SSkrzypik03/DigitalAmplifier/img/front_view_3.jpg

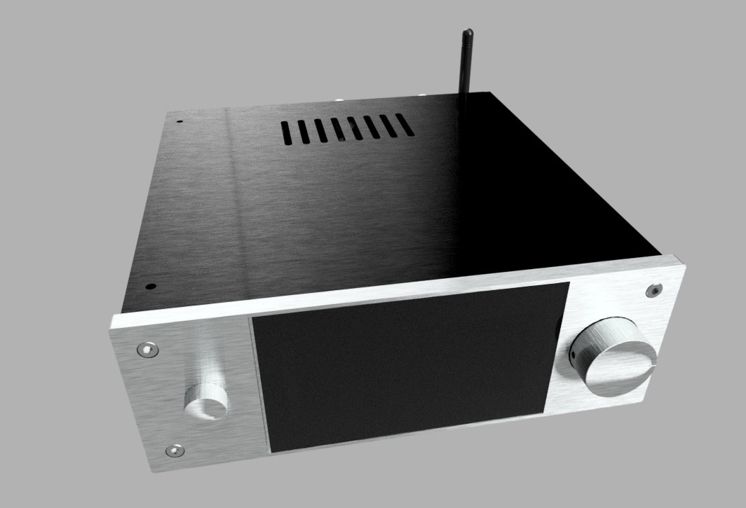
img/front_view_3.jpg
