SSkrzypik03/DigitalAmplifier/img/rear_view_1.jpg

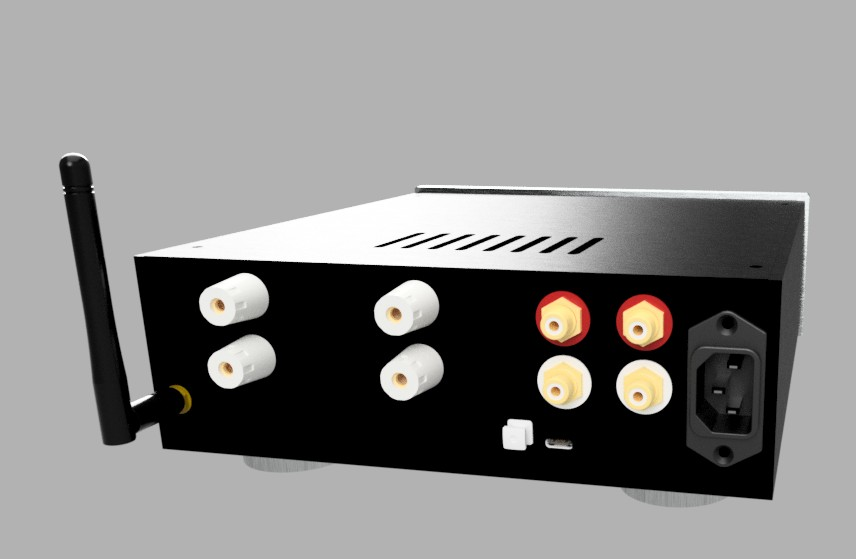
img/rear_view_1.jpg
