SSkrzypik03/DigitalAmplifier/cad/electronics_parts/power_supply_unit.step

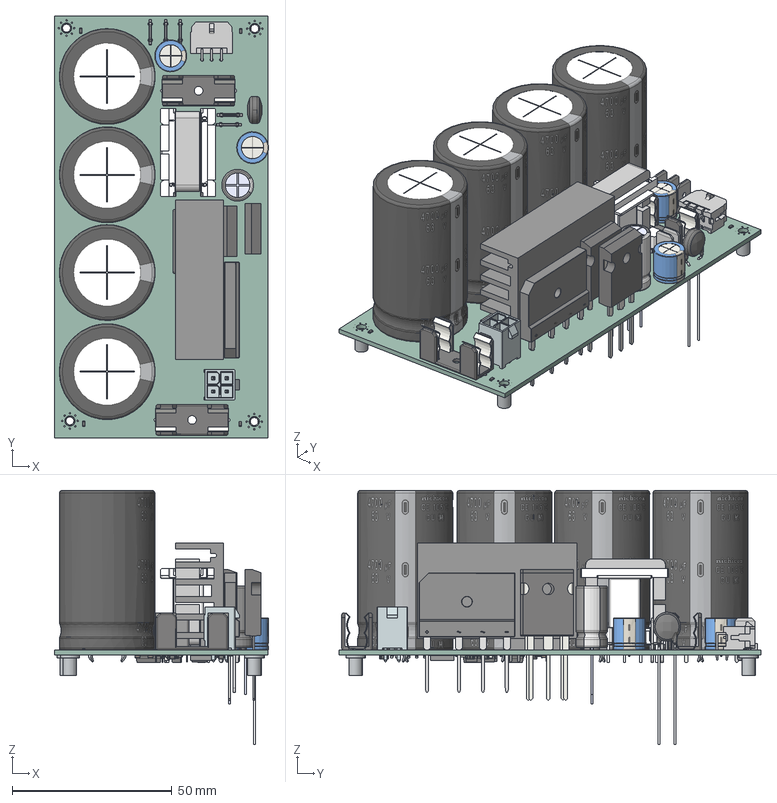
[picture p11: CAD file, 2026-06-03]
cad/electronics_parts/power_supply_unit.step
67.1 x 132.3 x 79.7 mm
9775056360R x 4
4700uF 63V Electr 30 x50 -P.diameter 10mm x 4
R_0603_1608Metric x 18
TO-247-3_Vertical
B66208W1010T001
B66317G0000X187 x 2
CP_Radial_D10.0mm_P2.50mm x 2
D15XB80-7000
RAD-DY-GF_5
Fuseholder_Cylinder-5x20mm_Schurter_0031_8201_Horizontal_Open x 2
B57153S0330M000
EEUFM1H271E
TO-247-2_Vertical
Pins
D_SMB x 2
SOT-23 x 2
SOT457 Lower body
SOT457 Lead x 6
SOT457 Upper body
PS2811-1-F3-A
C_0603_1608Metric x 9
D_SMA x 2
D_SOD-123
BODY-SOT_1 x 2
LEAD-SOT_1 x 10
LEAD-DUMMY x 2
D_SMC
BODY-SOT
LEAD-SOT x 6
R_2512_6332Metric
C_1206_3216Metric
R_2010_5025Metric
supply_PCB
