SSkrzypik03/DigitalAmplifier/cad/housing_parts/transformer_enclosure.step

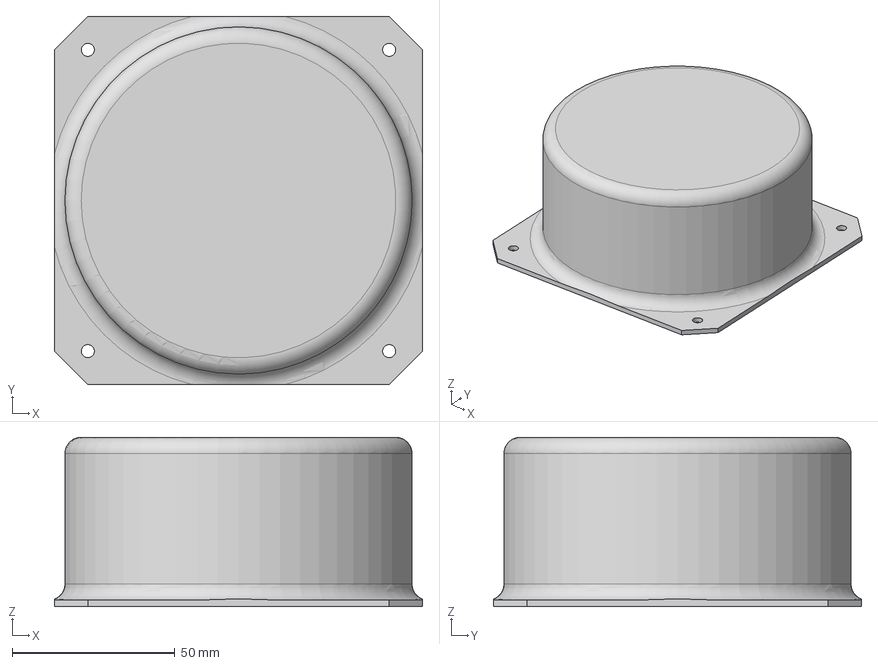
[picture p12: CAD file, 2026-06-03]
cad/housing_parts/transformer_enclosure.step
113.0 x 113.0 x 52.0 mm
