SSkrzypik03/DigitalAmplifier/hardware/front_panel/front_26_05_26.step

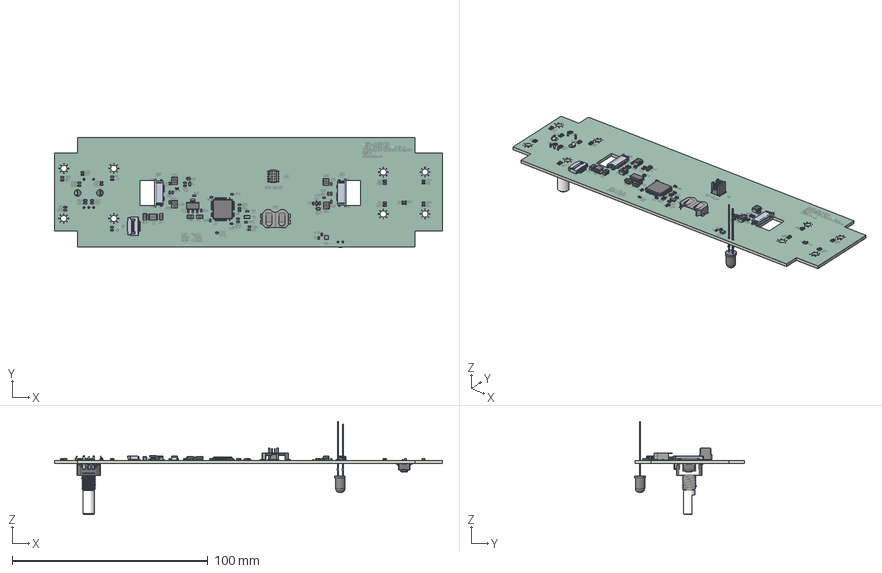
[picture p13: CAD file, 2026-06-01]
hardware/front_panel/front_26_05_26.step
198.4 x 56.4 x 47.8 mm
SOT-223
C_0603_1608Metric x 39
QT3CD-32.768KDZY-T
293D475X9016B2TE3 x 4
D_SOD-323F x 4
R_0603_1608Metric x 20
FTSH-105-01-L-DV-K
293D226X9010A2TE3 x 4
LQFP-64_10x10mm_P0.5mm
D_SOD-523
Kern x 2
Pin x 2
front_26_05_26 1.42.1
ThermalPin
PinsArrayLR
BatteryHolder_LINX_BAT-HLD-012-SMT
SW_SPST_PTS645Sx43SMTR92
SFH_203_FA
PEC11R-4220F-S0024
FrontPanel_silkscreen x 2
FrontPanel_soldermask x 2
FrontPanel_PCB
