SSkrzypik03/DigitalAmplifier/hardware/supply/supply_30_05_26.step

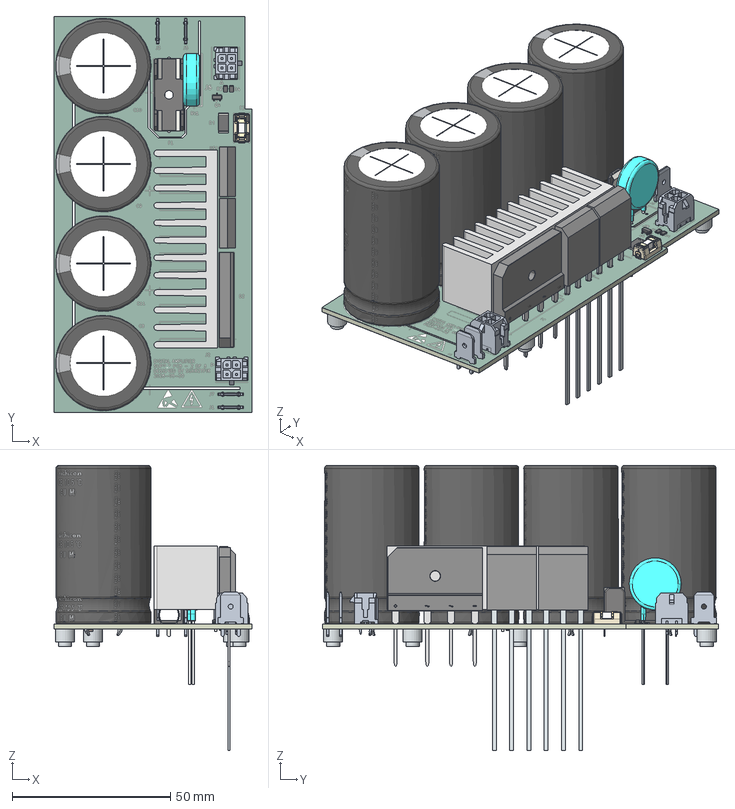
[picture p14: CAD file, 2026-06-01]
hardware/supply/supply_30_05_26.step
62.4 x 125.0 x 90.0 mm
4700uF 63V Electr 30 x50 -P.diameter 10mm x 4
Fuseholder_Cylinder-5x20mm_Schurter_0031_8201_Horizontal_Open
R_0805_2012Metric x 2
SOT-23
R_2512_6332Metric
PinsArray x 2
sk444
D15XB80-7000
MOV-14D431K
0679H1000-xxsingle fonts v2.step
Plastic holder-0.step
Terminal.step
9774040360R (rev1) x 5
R_0603_1608Metric x 3
C_0603_1608Metric x 3
supply_silkscreen x 2
supply_soldermask x 2
supply_PCB
