SSkrzypik03/DigitalAmplifier/cad/electronics_parts/front_panel.step

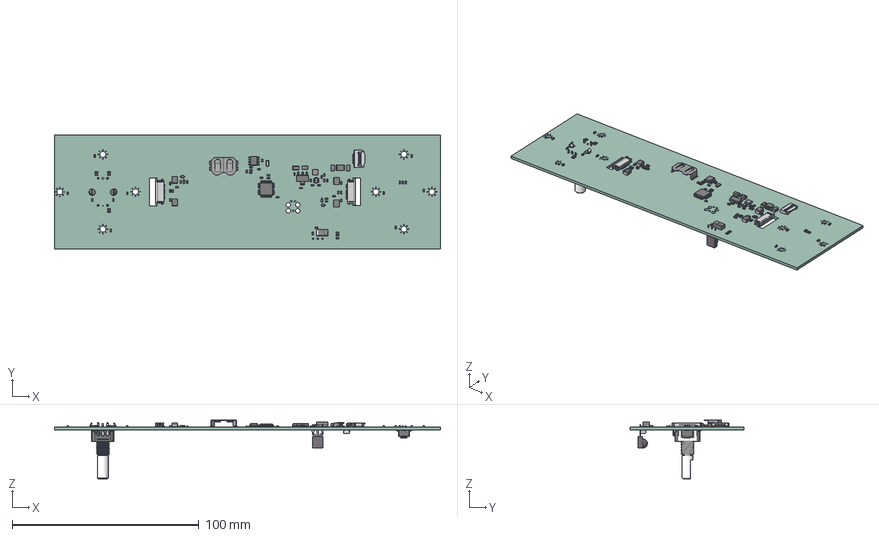
[picture p15: CAD file, 2026-06-03]
cad/electronics_parts/front_panel.step
206.8 x 61.1 x 31.5 mm
SOT-223
C_0603_1608Metric x 38
R_0603_1608Metric x 18
QT3CD-32.768KDZY-T
293D475X9016B2TE3 x 4
D_SOD-323F x 4
SOIC-8_3.9x4.9mm_P1.27mm
293D226X9010A2TE3 x 4
BODY-SOT
LEAD-SOT x 6
D_SOD-523
Kern
Kern_1
Pin
Pin_1
FrontPanel 1.38.1
LQFP-48_7x7mm_P0.5mm
293D476X96R3C2TE3
Pins
BatteryHolder_LINX_BAT-HLD-012-SMT
ASMB-MTB1-0B3A2
SW_SPST_PTS645Sx43SMTR92
Vishay_MINIMOLD-3Pin
PEC11R-4220F-S0024
FrontPanel_PCB
