SSkrzypik03/DigitalAmplifier/cad/housing_parts/volume_knob.step

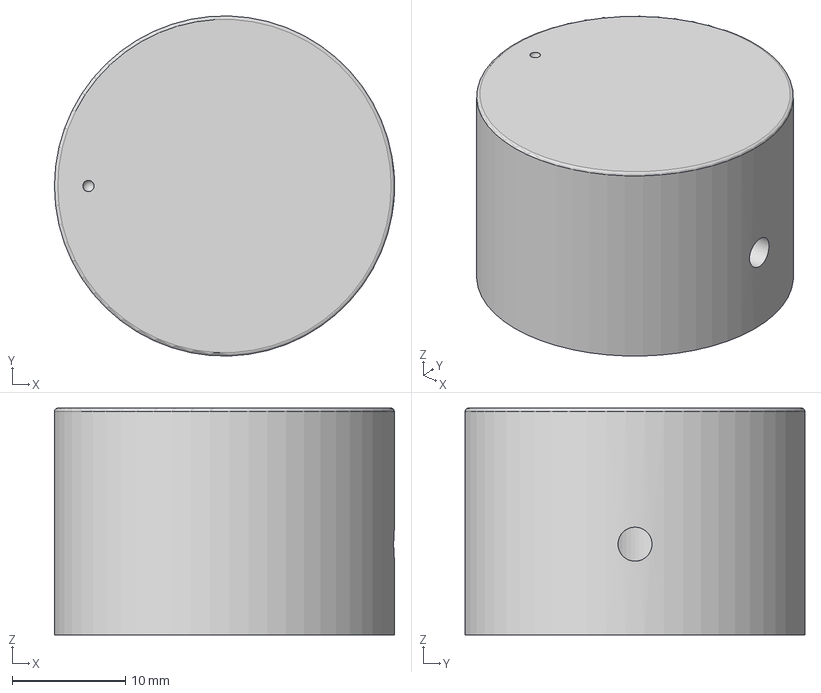
[picture p16: CAD file, 2026-06-03]
cad/housing_parts/volume_knob.step
30.0 x 30.0 x 20.0 mm
