SSkrzypik03/DigitalAmplifier/cad/housing_parts/bottom_plate.step

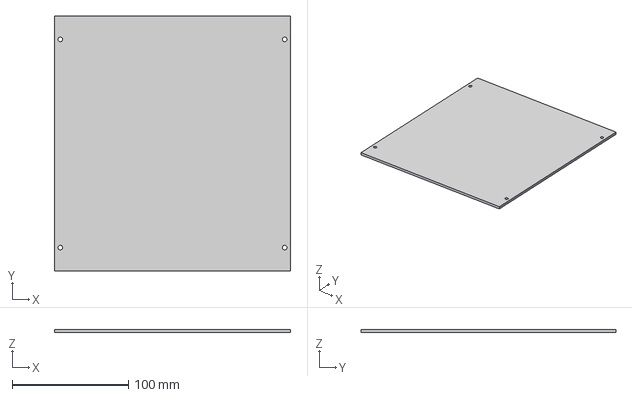
[picture p18: CAD file, 2026-06-03]
cad/housing_parts/bottom_plate.step
203.0 x 219.0 x 3.00 mm
