SSkrzypik03/DigitalAmplifier/cad/vendor_parts/0100.2130_02.step

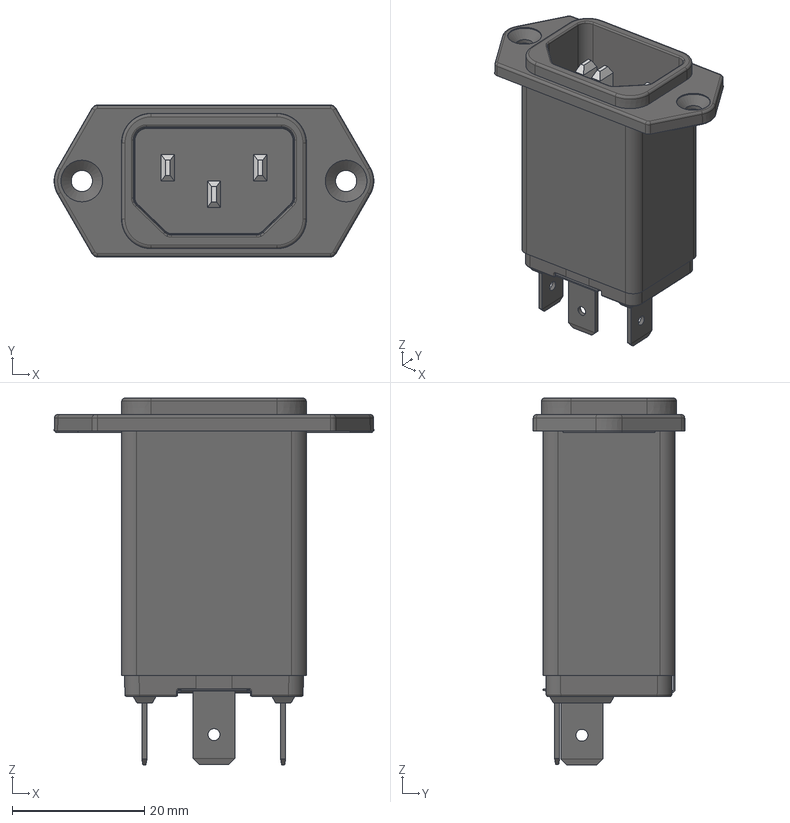
[picture p19: CAD file, 2026-06-03]
cad/vendor_parts/0100.2130_02.step
48.4 x 23.0 x 55.6 mm
