SSkrzypik03/DigitalAmplifier/cad/housing_parts/button.step

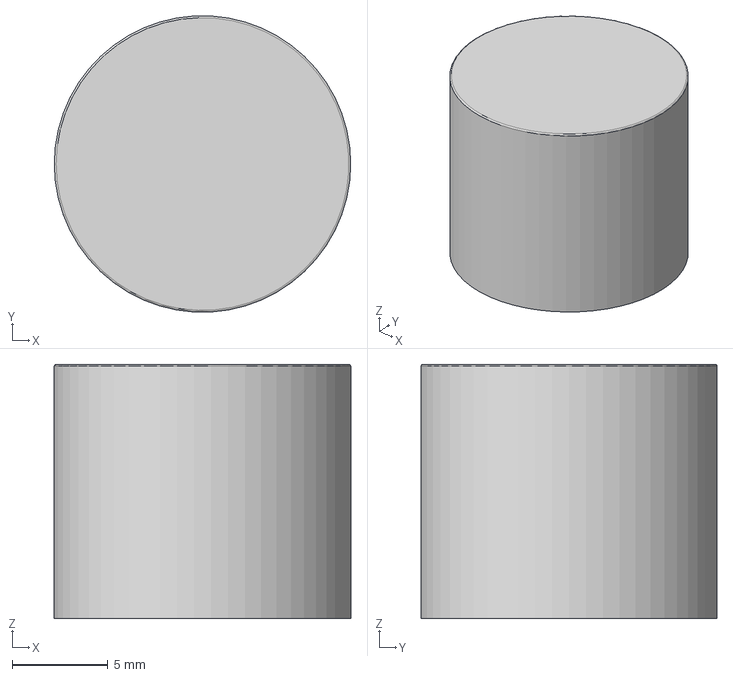
[picture p20: CAD file, 2026-06-03]
cad/housing_parts/button.step
15.5 x 15.5 x 13.3 mm
