SSkrzypik03/DigitalAmplifier/cad/housing_parts/leg.step

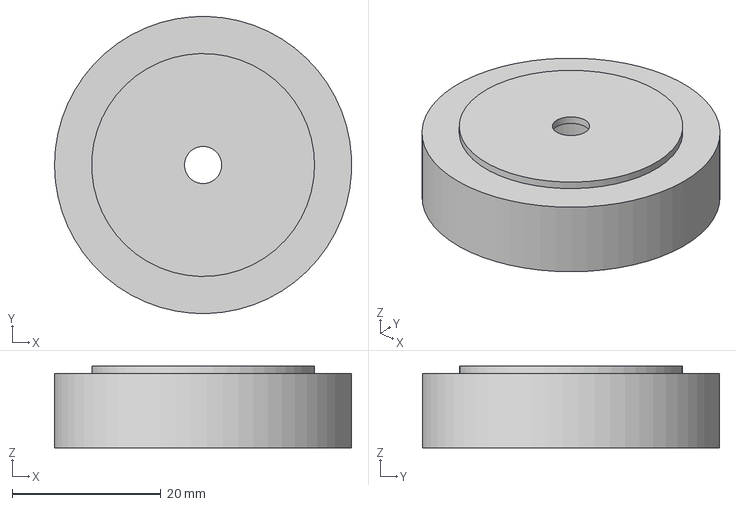
[picture p21: CAD file, 2026-06-03]
cad/housing_parts/leg.step
40.0 x 40.0 x 11.0 mm
