SSkrzypik03/DigitalAmplifier/cad/vendor_parts/RCA_chassis_White.step

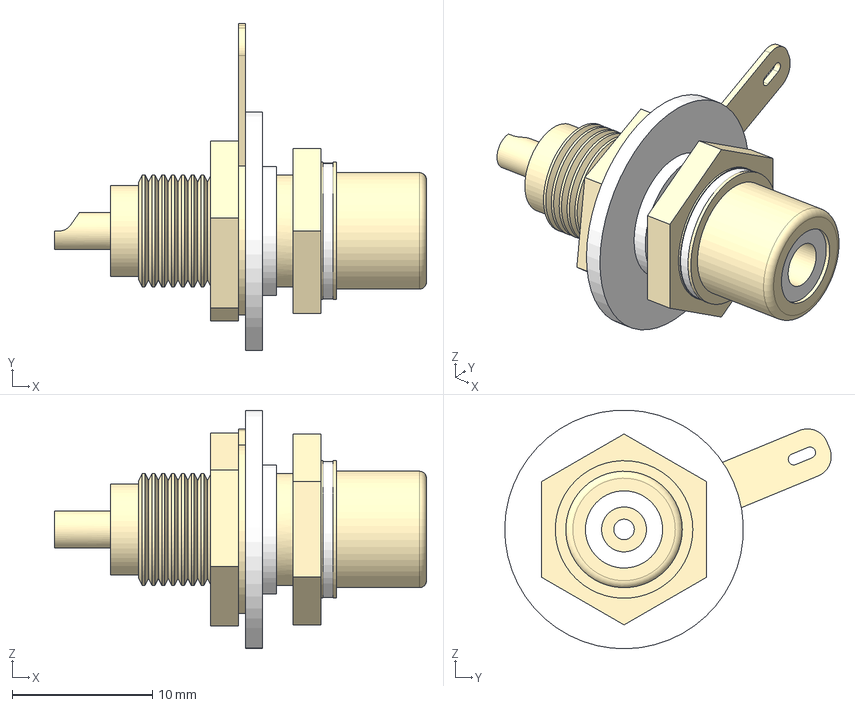
[picture p22: CAD file, 2026-06-03]
cad/vendor_parts/RCA_chassis_White.step
26.5 x 23.3 x 17.0 mm
RCA R
RCA izolator L
RCA usica
RCA matica
