SSkrzypik03/DigitalAmplifier/cad/housing_parts/front_pcb_spacer.step

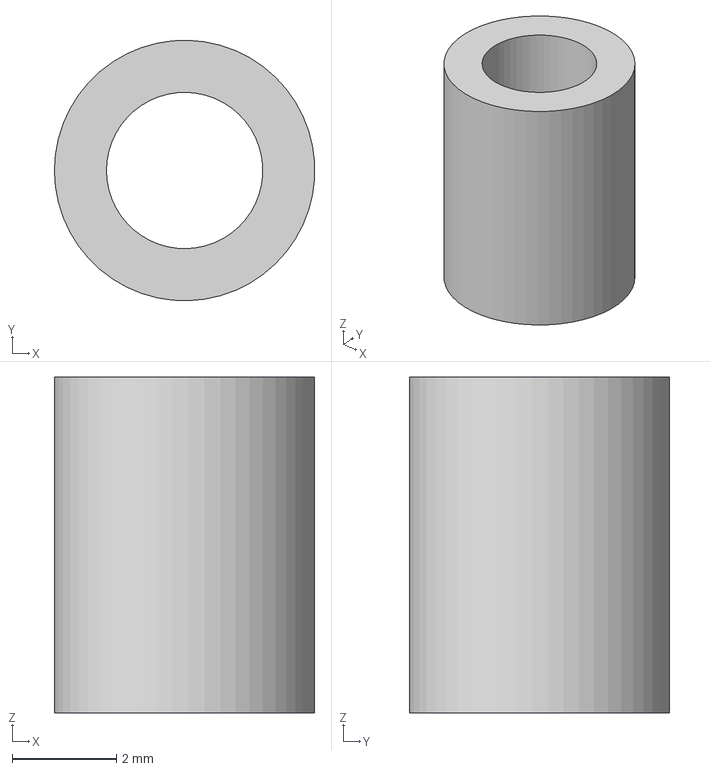
[picture p23: CAD file, 2026-06-03]
cad/housing_parts/front_pcb_spacer.step
5.00 x 5.00 x 6.45 mm
