SSkrzypik03/DigitalAmplifier/cad/vendor_parts/Antena 3 dBi 5.8 GHz v3.step

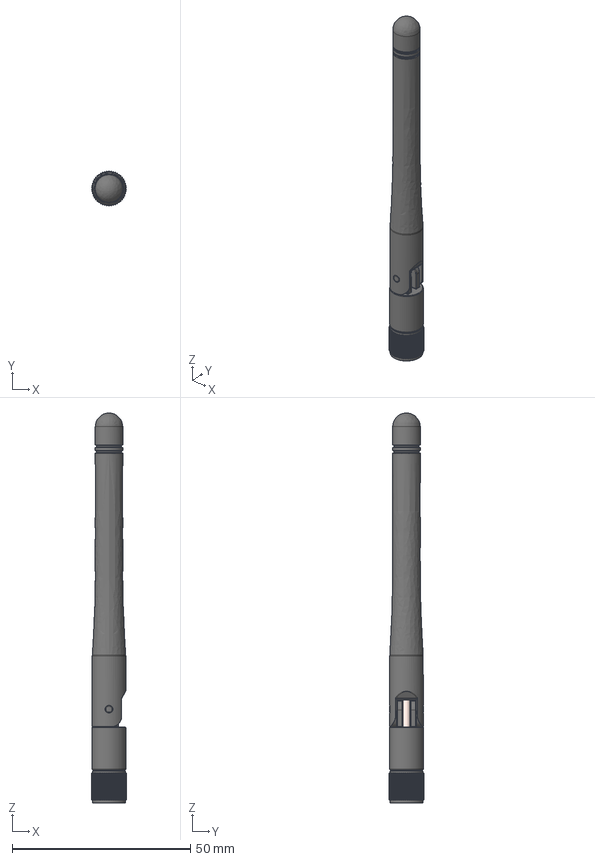
[picture p24: CAD file, 2026-06-03]
cad/vendor_parts/Antena 3 dBi 5.8 GHz v3.step
9.80 x 9.82 x 109.3 mm
Sma
Antena-1
Antena-2 x 2
Antena-stick
