SSkrzypik03/DigitalAmplifier/cad/housing_parts/side_plate.step

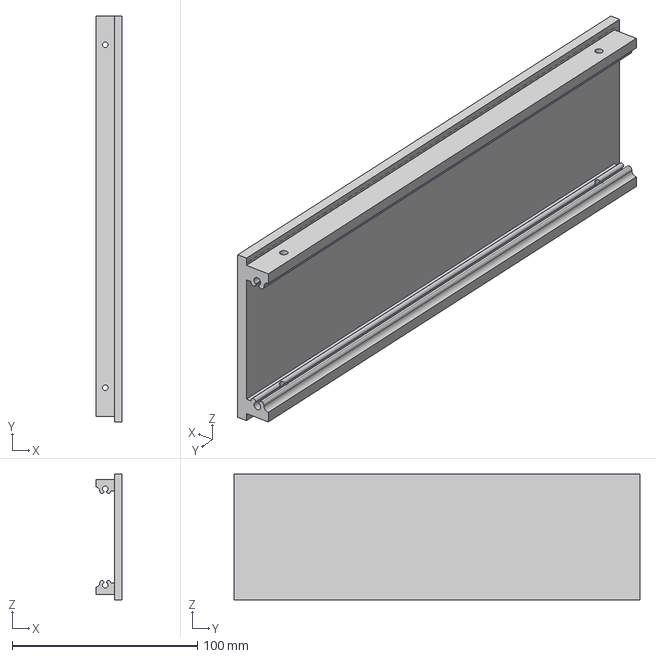
[picture p25: CAD file, 2026-06-03]
cad/housing_parts/side_plate.step
14.0 x 219.0 x 67.8 mm
