SSkrzypik03/DigitalAmplifier/cad/vendor_parts/ER-OLED0383-1.step

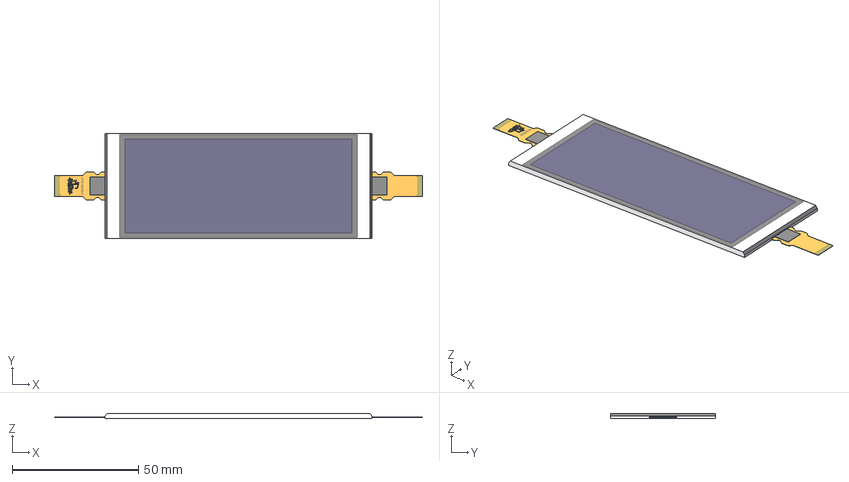
[picture p26: CAD file, 2026-06-03]
cad/vendor_parts/ER-OLED0383-1.step
145.5 x 41.7 x 2.03 mm
ER-OLED0308-1
ER-OLED0308-1 (1)
ER-OLED0308-1 (2)
ER-OLED0308-1 (3)
ER-OLED0308-1 (4)
3no_5logo
3no_5logo (1)
3no_5logo (2)
3no_5logo (3)
3no_5logo (4)
3no_5logo (5)
3no_5logo (6)
3no_5logo (7)
3no_5logo (8)
3no_5logo (9)
3no_5logo (10)
3no_5logo (11)
3no_5logo (12)
3no_5logo (13)
3no_5logo (14)
3no_5logo (15)
3no_5logo (16)
3no_5logo (17)
3no_5logo (18)
3no_5logo (19)
3no_5logo (20)
3no_5logo (21)
3no_5logo (22)
3no_5logo (23)
3no_5logo (24)
3no_5logo (25)
3no_5logo (26)
3no_5logo (27)
3no_5logo (28)
3no_5logo (29)
3no_5logo (30)
