SSkrzypik03/DigitalAmplifier/cad/housing_parts/button_spacer.step

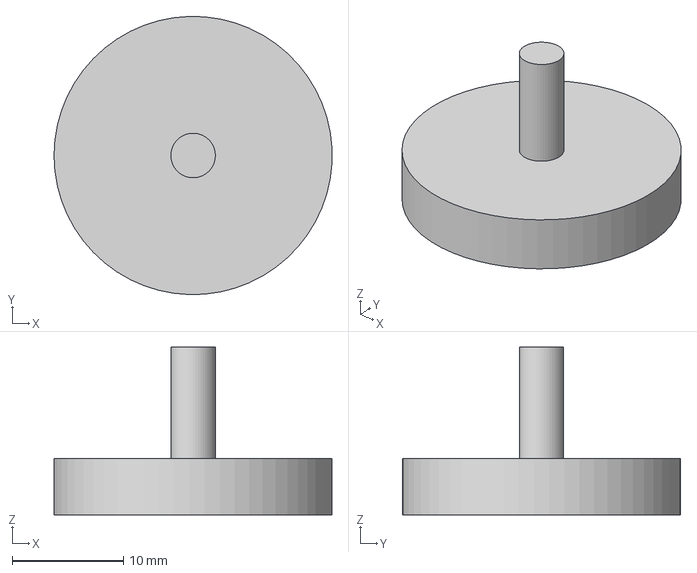
[picture p27: CAD file, 2026-06-03]
cad/housing_parts/button_spacer.step
25.0 x 25.0 x 15.1 mm
