SSkrzypik03/DigitalAmplifier/(list of files, cad)

Other CAD files:
hardware/supply/supply_26_05_26.step
cad/housing_parts/top_plate.step
cad/vendor_parts/1053072-1.step
cad/vendor_parts/Allen key bolt M8.step
cad/vendor_parts/Binding Post Gold-Plated Screwable.step
