SSkrzypik03/DigitalAmplifier/spice/supply.asc

C1: cap; 40m; Rser=50m
D1: diode
D2: diode
D3: diode
D4: diode
Lp: ind2; 36.6; Rser=20
Ls: ind2; 1; Rser=1
Q1: pnp; 2SAR582D3
Q2: pnp; 2SAR582D3
Q4: pnp; BC857C
Q5: pnp; 2SAR582D3
Q7: pnp; 2SAR582D3
R1: res; 70m
R2: res; 4.7k
R5: res; 10k
R6: res; 100k
R7: res; 100k
R8: res; 8k
R9: res; 8k
R10: res; 10k
Rload: res; 20
V2: voltage; SINE(0 325 60)
Named nets: 0, E
.tran 0 5 0 10u startup
K1 Lp Ls 0.999
