SSkrzypik03/DigitalAmplifier/spice/dac_frontend.asc

C1: cap; 3.98n
C2: cap; 39.8n
C3: cap; 39.8n
C7: cap; 4.7µ
R1: res; 8.45k
R2: res; 8.45k
R3: res; 8.45k
R4: res; 10k
R5: res; 10k
R6: res; 10k
R7: res; 10k
R8: res; 8.45k
R9: res; 50
R10: res; 50
R11: res; 10k
R12: res; 10k
R13: res; 10k
R14: res; 10k
R15: res; 10k
R16: res; 47
R17: res; 1Meg
U1: UniversalOpAmp
U2: UniversalOpAmp
U5: UniversalOpAmp
V1: voltage; SINE(1.65 1.65 1k); AC 1
V2: voltage; SINE(1.65 -1.65 1k); AC 1
V3: voltage; 1.65
V4: voltage; 2.5
V5: voltage; 12
Named nets: DAC_P, 0, DAC_N, 12v, 1.65V, PREOUT, 2.5V, OUT_P, OUT_N
.ac oct 1k 1 196k
.tran 0 20m 10m
Uout(t)=0.8485*(Uin(t)-1.65)+2.5
shifting Uref from 1.65V to 2.5V and matching voltage ranges between TAC5242 and TPA8255.
Fc = 80khz
https://e2e.ti.com/blogs_/archives/b/precisionhub/posts/three-guidelines-for-designing-anti-aliasing-filters
