SSkrzypik03/DigitalAmplifier/hardware/mainboard/DigitalAmplifier.kicad_pcb

## KiCad design hardware/mainboard/DigitalAmplifier.kicad_pcb (2026-06-01)

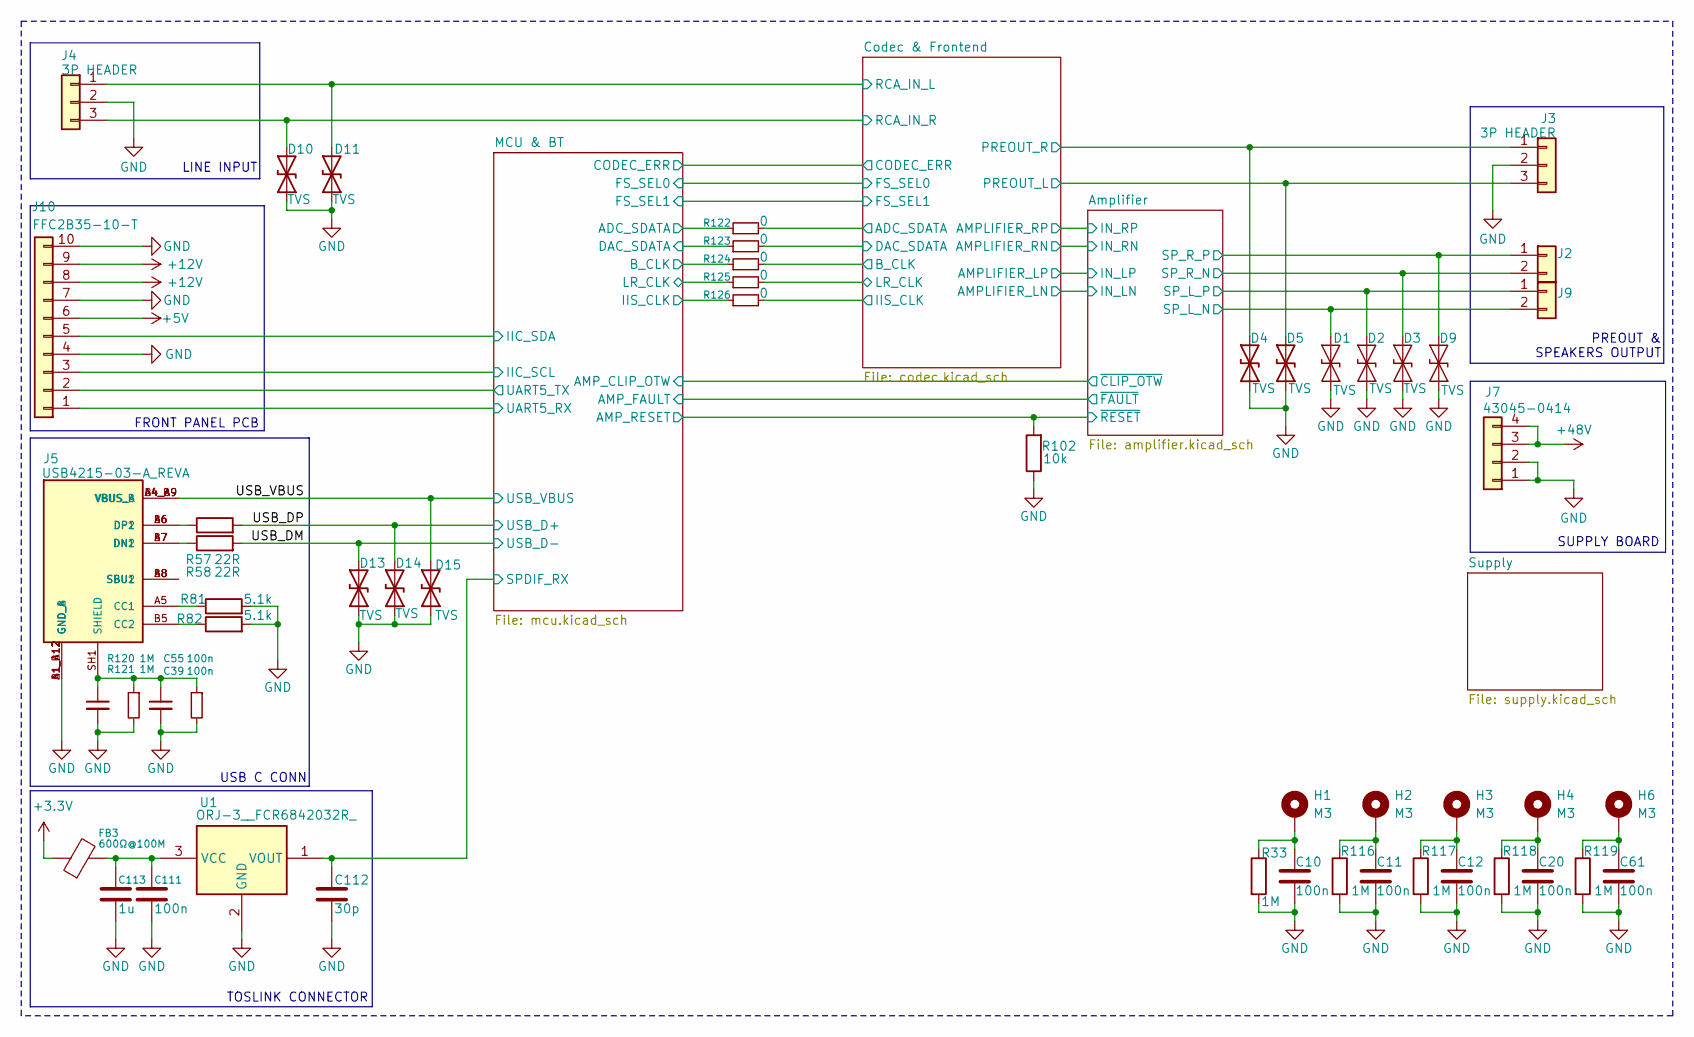
[picture p28: schematic DigitalAmplifier.kicad_sch]

Parts:
C10, C11, C12, C20, C39, C55, C61, C111: 100n; C_0603_1608Metric; Manufacturer_Part_Number 0603B104K500CT
C112: 30p; C_0603_1608Metric; Manufacturer_Part_Number C0603C300J5GACTU
C113: 1u; C_0603_1608Metric; Manufacturer_Part_Number CL10A105KB8NNNC
D1, D2, D3, D9: TVS; D_SMA; Manufacturer_Part_Number P4SMAJ6.5CA
D4, D5, D10, D11, D13, D14, D15: TVS; STN061050BL40; Manufacturer_Part_Number STN061050BL40-EA
FB3: 600Ω@100M; L_0603_1608Metric; Manufacturer_Part_Number BLM18AG601SN1D
H1, H2, H3, H4, H6: M3; WA-SMSI_97730256330; Manufacturer_Part_Number 9774040360R
J2, J9: Conn_01x02; 43650-02YY_151617; Manufacturer_Part_Number 43650-0215
J3, J4: 3P HEADER; JST_PH_B3B-PH-K_1x03_P2.00mm_Vertical; Manufacturer_Part_Number B3B-PH-K-S (LF)(SN)
J5: USB4215-03-A_REVA; GCT_USB4215-03-A_REVA; PARTREV A
J7: 43045-0414; 43045-04YY_121314; Manufacturer_Part_Number 43045-04YY_121314
J10: FFC2B35-10-T; FFC2B3510T; Manufacturer_Part_Number FFC2B3510T
R33, R116, R117, R118, R119, R120, R121: 1M; R_0603_1608Metric; Manufacturer_Part_Number RC0603JR-071ML
R57, R58: 22R; R_0603_1608Metric; Manufacturer_Part_Number WR06X220 JTL
R81, R82: 5.1k; R_0603_1608Metric; Manufacturer_Part_Number WR06X5101FTL
R102: 10k; R_0603_1608Metric; Manufacturer_Part_Number RC0603JR-0710KL
R122, R123, R124, R125, R126: 0; R_0402_1005Metric_Pad0.72x0.64mm_HandSolder; Manufacturer_Part_Number RC0402JR-070RL
U1: ORJ-3__FCR6842032R_; ORJ3FCR6842032R; Manufacturer_Part_Number ORJ-3 (FCR6842032R)

Connections:
+3.3V: FB3.1; also elsewhere on the board
+5V: J10.6; also elsewhere on the board
+12V: J10.8, J10.9; also elsewhere on the board
+48V: J7.3, J7.4; also elsewhere on the board
/Amplifier/SP_L_N: D1.2 (A2), J9.2; also elsewhere on the board
/Amplifier/SP_L_P: D2.2 (A2), J9.1; also elsewhere on the board
/Amplifier/SP_R_N: D3.2 (A2), J2.2; also elsewhere on the board
/Amplifier/SP_R_P: D9.2 (A2), J2.1; also elsewhere on the board
/Amplifier/~RESET: R102.2; also elsewhere on the board
/Codec & Frontend/ADC_SDATA: R122.2; also elsewhere on the board
/Codec & Frontend/B_CLK: R124.2; also elsewhere on the board
/Codec & Frontend/DAC_SDATA: R123.2; also elsewhere on the board
/Codec & Frontend/IIS_CLK: R126.2; also elsewhere on the board
/Codec & Frontend/LR_CLK: R125.2; also elsewhere on the board
/Codec & Frontend/PREOUT_L: D5.2 (A2), J3.3; also elsewhere on the board
/Codec & Frontend/PREOUT_R: D4.2 (A2), J3.1; also elsewhere on the board
/Codec & Frontend/RCA_IN_L: D11.2 (A2), J4.1; also elsewhere on the board
/Codec & Frontend/RCA_IN_R: D10.2 (A2), J4.3; also elsewhere on the board
/MCU & BT/ADC_SDATA: R122.1; also elsewhere on the board
/MCU & BT/B_CLK: R124.1; also elsewhere on the board
/MCU & BT/DAC_SDATA: R123.1; also elsewhere on the board
/MCU & BT/IIC_SCL: J10.3; also elsewhere on the board
/MCU & BT/IIC_SDA: J10.5; also elsewhere on the board
/MCU & BT/IIS_CLK: R126.1; also elsewhere on the board
/MCU & BT/LR_CLK: R125.1; also elsewhere on the board
/MCU & BT/SPDIF_RX: C112.1, U1.1 (VOUT); also elsewhere on the board
/MCU & BT/UART5_RX: J10.1; also elsewhere on the board
/MCU & BT/UART5_TX: J10.2; also elsewhere on the board
/USB_DM: D13.2 (A2), R58.2; also elsewhere on the board
/USB_DP: D14.2 (A2), R57.2; also elsewhere on the board
/USB_VBUS: D15.2 (A2), J5.A4_B9 (VBUS_A), J5.B4_A9 (VBUS_B); also elsewhere on the board
GND: C10.2, C11.2, C12.2, C20.2, C39.2, C55.2, C61.2, C111.2, C112.2, C113.2, D1.1 (A1), D2.1 (A1), D3.1 (A1), D4.1 (A1), D5.1 (A1), D9.1 (A1), D10.1 (A1), D11.1 (A1), D13.1 (A1), D14.1 (A1), D15.1 (A1), J3.2, J4.2, J5.A1_B12 (GND_A), J5.B1_A12 (GND_B), J7.1, J7.2, J10.4, J10.7, J10.10, R33.2, R81.2, R82.2, R102.1, R116.2, R117.2, R118.2, R119.2, R120.2, R121.2, U1.2 (GND); also elsewhere on the board
unnamed: C10.1, H1.1 (1_1), R33.1
unnamed: C11.1, H2.1 (1_1), R116.1
unnamed: C12.1, H3.1 (1_1), R117.1
unnamed: C20.1, H4.1 (1_1), R118.1
unnamed: C39.1, C55.1, J5.SH1 (SHIELD), J5.SH2 (SHIELD), J5.SH3 (SHIELD), J5.SH4 (SHIELD), R120.1, R121.1
unnamed: C61.1, H6.1 (1_1), R119.1
unnamed: J5.A5 (CC1), R81.1
unnamed: J5.B5 (CC2), R82.1
unnamed: J5.A7 (DN1), J5.B7 (DN2), R58.1
unnamed: J5.A6 (DP1), J5.B6 (DP2), R57.1
unnamed: J5.A8 (SBU1), J5.B8 (SBU2)
unnamed: C111.1, C113.1, FB3.2, U1.3 (VCC)

Notes on the sheet:
USB C CONN
SUPPLY BOARD
PREOUT & SPEAKERS OUTPUT
FRONT PANEL PCB
LINE INPUT
TOSLINK CONNECTOR

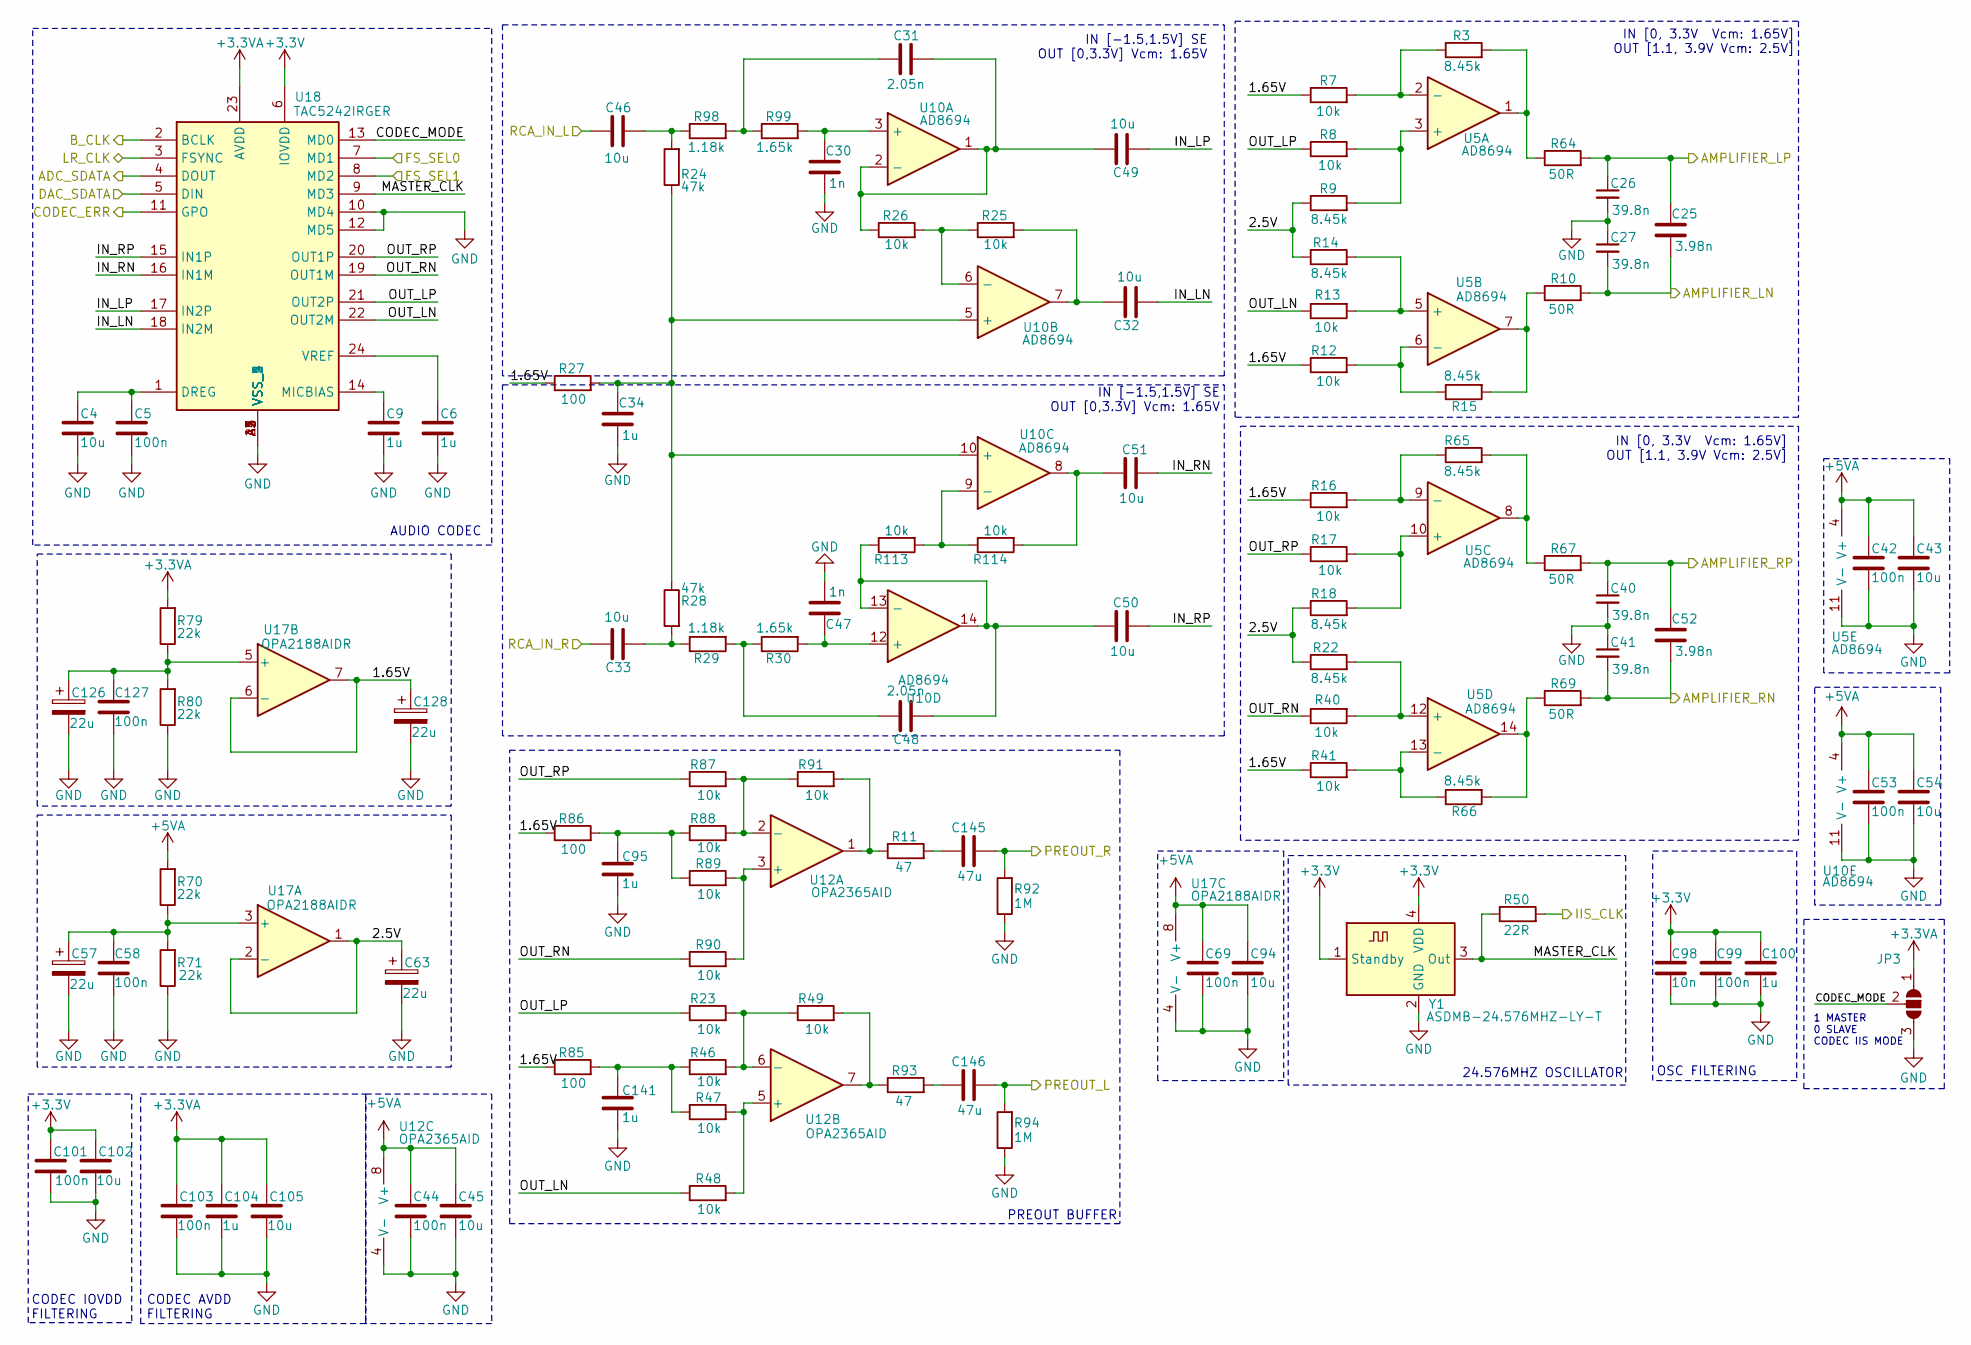
[picture p29: schematic codec.kicad_sch]

Parts:
C4, C43, C45, C54, C94, C102, C105: 10u; C_0603_1608Metric; Manufacturer_Part_Number GRM188R61E106KA73J
C5, C42, C44, C53, C58, C69, C99, C101, C103, C127: 100n; C_0603_1608Metric; Manufacturer_Part_Number 0603B104K500CT
C6, C9, C34, C100, C104: 1u; C_0603_1608Metric; Manufacturer_Part_Number CL10A105KB8NNNC
C25, C52: 3.98n; C_0603_1608Metric; Manufacturer_Part_Number GCM1885C1H392JA16D
C26, C27, C40, C41: 39.8n; C_0603_1608Metric; Manufacturer_Part_Number C0603C393K5RACTU
C30, C47: 1n; C_0603_1608Metric; Manufacturer_Part_Number 0603B102K500CT
C31, C48: 2.05n; C_0603_1608Metric; Manufacturer_Part_Number GCM188R71H272KA37D
C32, C33, C46, C49, C50, C51: 10u; C_0805_2012Metric; Manufacturer_Part_Number GRM21BR61E106KA73L
C57, C63, C126, C128: 22u; CAPPM3216X180N; Manufacturer_Part_Number 293D226X9010A2TE3
C95, C141: 1u; C_0805_2012Metric; Manufacturer_Part_Number CL21B105KAFNNNE
C98: 10n; C_0603_1608Metric; Manufacturer_Part_Number 06035C103KAT2A
C145, C146: 47u; C_0805_2012Metric; Manufacturer_Part_Number CL21A476MQYNNNE
JP3: SolderJumper_3_Open; SolderJumper-3_P1.3mm_Open_RoundedPad1.0x1.5mm
R3, R9, R14, R15, R18, R22, R65, R66: 8.45k; R_0603_1608Metric; Manufacturer_Part_Number ERA3AEB8661V
R7, R8, R12, R13, R16, R17, R23, R25, R26, R40, R41, R46, R47, R48, R49, R87, R88, R89, R90, R91, R113, R114: 10k; R_0603_1608Metric; Manufacturer_Part_Number RC0603JR-0710KL
R10, R64, R67, R69: 50R; R_0603_1608Metric; Manufacturer_Part_Number AR03BTCX0500
R11, R93: 47; R_0603_1608Metric; Manufacturer_Part_Number RC0603JR-0747RL
R24, R28: 47k; R_0603_1608Metric; Manufacturer_Part_Number RC0603JR-0747KL
R27, R85, R86: 100; R_0603_1608Metric; Manufacturer_Part_Number WR06X101 JTL
R29, R98: 1.18k; R_0603_1608Metric; Manufacturer_Part_Number ERA3AEB1181V
R30, R99: 1.65k; R_0603_1608Metric; Manufacturer_Part_Number ERA3AEB1651V
R50: 22R; R_0603_1608Metric; Manufacturer_Part_Number WR06X220 JTL
R70, R71, R79, R80: 22k; R_0603_1608Metric; Manufacturer_Part_Number WR06X2202FTL
R92, R94: 1M; R_0603_1608Metric; Manufacturer_Part_Number RC0603JR-071ML
U5, U10: AD8694; TSSOP-14_4.4x5mm_P0.65mm; Manufacturer_Part_Number AD8694
U12: OPA2365AID; SOIC-8_3.9x4.9mm_P1.27mm; Manufacturer_Part_Number OPA2365AID
U17: OPA2188AIDR; SOIC-8_3.9x4.9mm_P1.27mm; Manufacturer_Part_Number OPA2188AIDR
U18: TAC5242IRGER; Mouser Part Number 595-TAC5242IRGER
Y1: ASDMB-24.576MHZ-LY-T; Oscillator_SMD_Abracon_ASDMB-4Pin_2.5x2.0mm; Manufacturer_Part_Number ASDMB-24.576MHZ-LY-T

Connections:
+3.3V: C98.1, C99.1, C100.1, C101.1, C102.1, U18.6 (IOVDD), Y1.1 (Standby), Y1.4 (VDD); also elsewhere on the board
+3.3VA: C103.1, C104.1, C105.1, JP3.1 (A), R79.2, U18.23 (AVDD); also elsewhere on the board
+5VA: C42.1, C43.1, C44.1, C45.1, C53.1, C54.1, C69.1, C94.1, R70.2, U5.4 (V+), U10.4 (V+), U12.8 (V+), U17.8 (V+); also elsewhere on the board
/Amplifier/IN_LN: C25.2, C27.2, R10.2; also elsewhere on the board
/Amplifier/IN_LP: C25.1, C26.1, R64.2; also elsewhere on the board
/Amplifier/IN_RN: C41.2, C52.2, R69.2; also elsewhere on the board
/Amplifier/IN_RP: C40.1, C52.1, R67.2; also elsewhere on the board
/Codec & Frontend/1.65V: C128.1, R7.1, R12.1, R16.1, R27.1, R41.1, R85.1, R86.1, U17.6 (-), U17.7
/Codec & Frontend/2.5V: C63.1, R9.1, R14.1, R18.1, R22.1, U17.1, U17.2 (-)
/Codec & Frontend/ADC_SDATA: U18.4 (DOUT); also elsewhere on the board
/Codec & Frontend/B_CLK: U18.2 (BCLK); also elsewhere on the board
/Codec & Frontend/CODEC_ERR: U18.11 (GPO); also elsewhere on the board
/Codec & Frontend/CODEC_MODE: JP3.2 (C), U18.13 (MD0)
/Codec & Frontend/DAC_SDATA: U18.5 (DIN); also elsewhere on the board
/Codec & Frontend/FS_SEL0: U18.7 (MD1); also elsewhere on the board
/Codec & Frontend/FS_SEL1: U18.8 (MD2); also elsewhere on the board
/Codec & Frontend/IIS_CLK: R50.2; also elsewhere on the board
/Codec & Frontend/IN_LN: C32.1, U18.18 (IN2M)
/Codec & Frontend/IN_LP: C49.2, U18.17 (IN2P)
/Codec & Frontend/IN_RN: C51.2, U18.16 (IN1M)
/Codec & Frontend/IN_RP: C50.2, U18.15 (IN1P)
/Codec & Frontend/LR_CLK: U18.3 (FSYNC); also elsewhere on the board
/Codec & Frontend/MASTER_CLK: R50.1, U18.9 (MD3), Y1.3 (Out)
/Codec & Frontend/OUT_LN: R13.1, R48.1, U18.22 (OUT2M)
/Codec & Frontend/OUT_LP: R8.1, R23.1, U18.21 (OUT2P)
/Codec & Frontend/OUT_RN: R40.1, R90.1, U18.19 (OUT1M)
/Codec & Frontend/OUT_RP: R17.1, R87.1, U18.20 (OUT1P)
/Codec & Frontend/PREOUT_L: C146.2, R94.2; also elsewhere on the board
/Codec & Frontend/PREOUT_R: C145.2, R92.2; also elsewhere on the board
/Codec & Frontend/RCA_IN_L: C46.1; also elsewhere on the board
/Codec & Frontend/RCA_IN_R: C33.1; also elsewhere on the board
GND: C4.2, C5.2, C6.2, C9.2, C26.2, C27.1, C30.2, C34.2, C40.2, C41.1, C42.2, C43.2, C44.2, C45.2, C47.2, C53.2, C54.2, C57.2, C58.2, C63.2, C69.2, C94.2, C95.2, C98.2, C99.2, C100.2, C101.2, C102.2, C103.2, C104.2, C105.2, C126.2, C127.2, C128.2, C141.2, JP3.3 (B), R71.1, R80.1, R92.1, R94.1, U5.11 (V-), U10.11 (V-), U12.4 (V-), U17.4 (V-), U18.10 (MD4), U18.12 (MD5), U18.25 (VSS_1), U18.A1 (VSS_2), U18.A2 (VSS_3), U18.A3 (VSS_4), U18.A4 (VSS_5), Y1.2 (GND); also elsewhere on the board
unnamed: C31.1, R98.2, R99.1
unnamed: C32.2, R25.2, U10.7
unnamed: C33.2, R28.2, R29.1
unnamed: C46.2, R24.2, R98.1
unnamed: C48.1, R29.2, R30.1
unnamed: C51.1, R114.2, U10.8
unnamed: C95.1, R86.2, R88.1, R89.1
unnamed: C141.1, R46.1, R47.1, R85.2
unnamed: C145.1, R11.2
unnamed: C146.1, R93.2
unnamed: R3.2, R64.1, U5.1
unnamed: R10.1, R15.2, U5.7
unnamed: R11.1, R91.2, U12.1
unnamed: R49.2, R93.1, U12.7
unnamed: R65.2, R67.1, U5.8
unnamed: R66.2, R69.1, U5.14
unnamed: R8.2, R9.2, U5.3 (+)
unnamed: R3.1, R7.2, U5.2 (-)
unnamed: R13.2, R14.2, U5.5 (+)
unnamed: R12.2, R15.1, U5.6 (-)
unnamed: R17.2, R18.2, U5.10 (+)
unnamed: R16.2, R65.1, U5.9 (-)
unnamed: R22.2, R40.2, U5.12 (+)
unnamed: R41.2, R66.1, U5.13 (-)
unnamed: C30.1, R99.2, U10.3 (+)
unnamed: C31.2, C49.1, R26.1, U10.1, U10.2 (-)
unnamed: C34.1, R24.1, R27.2, R28.1, U10.5 (+), U10.10 (+)
unnamed: R25.1, R26.2, U10.6 (-)
unnamed: R113.2, R114.1, U10.9 (-)
unnamed: C47.1, R30.2, U10.12 (+)
unnamed: C48.2, C50.1, R113.1, U10.13 (-), U10.14
unnamed: R89.2, R90.2, U12.3 (+)
unnamed: R87.2, R88.2, R91.1, U12.2 (-)
unnamed: R47.2, R48.2, U12.5 (+)
unnamed: R23.2, R46.2, R49.1, U12.6 (-)
unnamed: C57.1, C58.1, R70.1, R71.2, U17.3 (+)
unnamed: C126.1, C127.1, R79.1, R80.2, U17.5 (+)
unnamed: C4.1, C5.1, U18.1 (DREG)
unnamed: C9.1, U18.14 (MICBIAS)
unnamed: C6.1, U18.24 (VREF)

Notes on the sheet:
CODEC AVDD FILTERING
IN [0, 3.3V Vcm: 1.65V] OUT [1.1, 3.9V Vcm: 2.5V]
PREOUT BUFFER
OSC FILTERING
IN [-1.5,1.5V] SE OUT [0,3.3V] Vcm: 1.65V
1 MASTER 0 SLAVE CODEC IIS MODE
AUDIO CODEC
24.576MHZ OSCILLATOR
CODEC IOVDD FILTERING

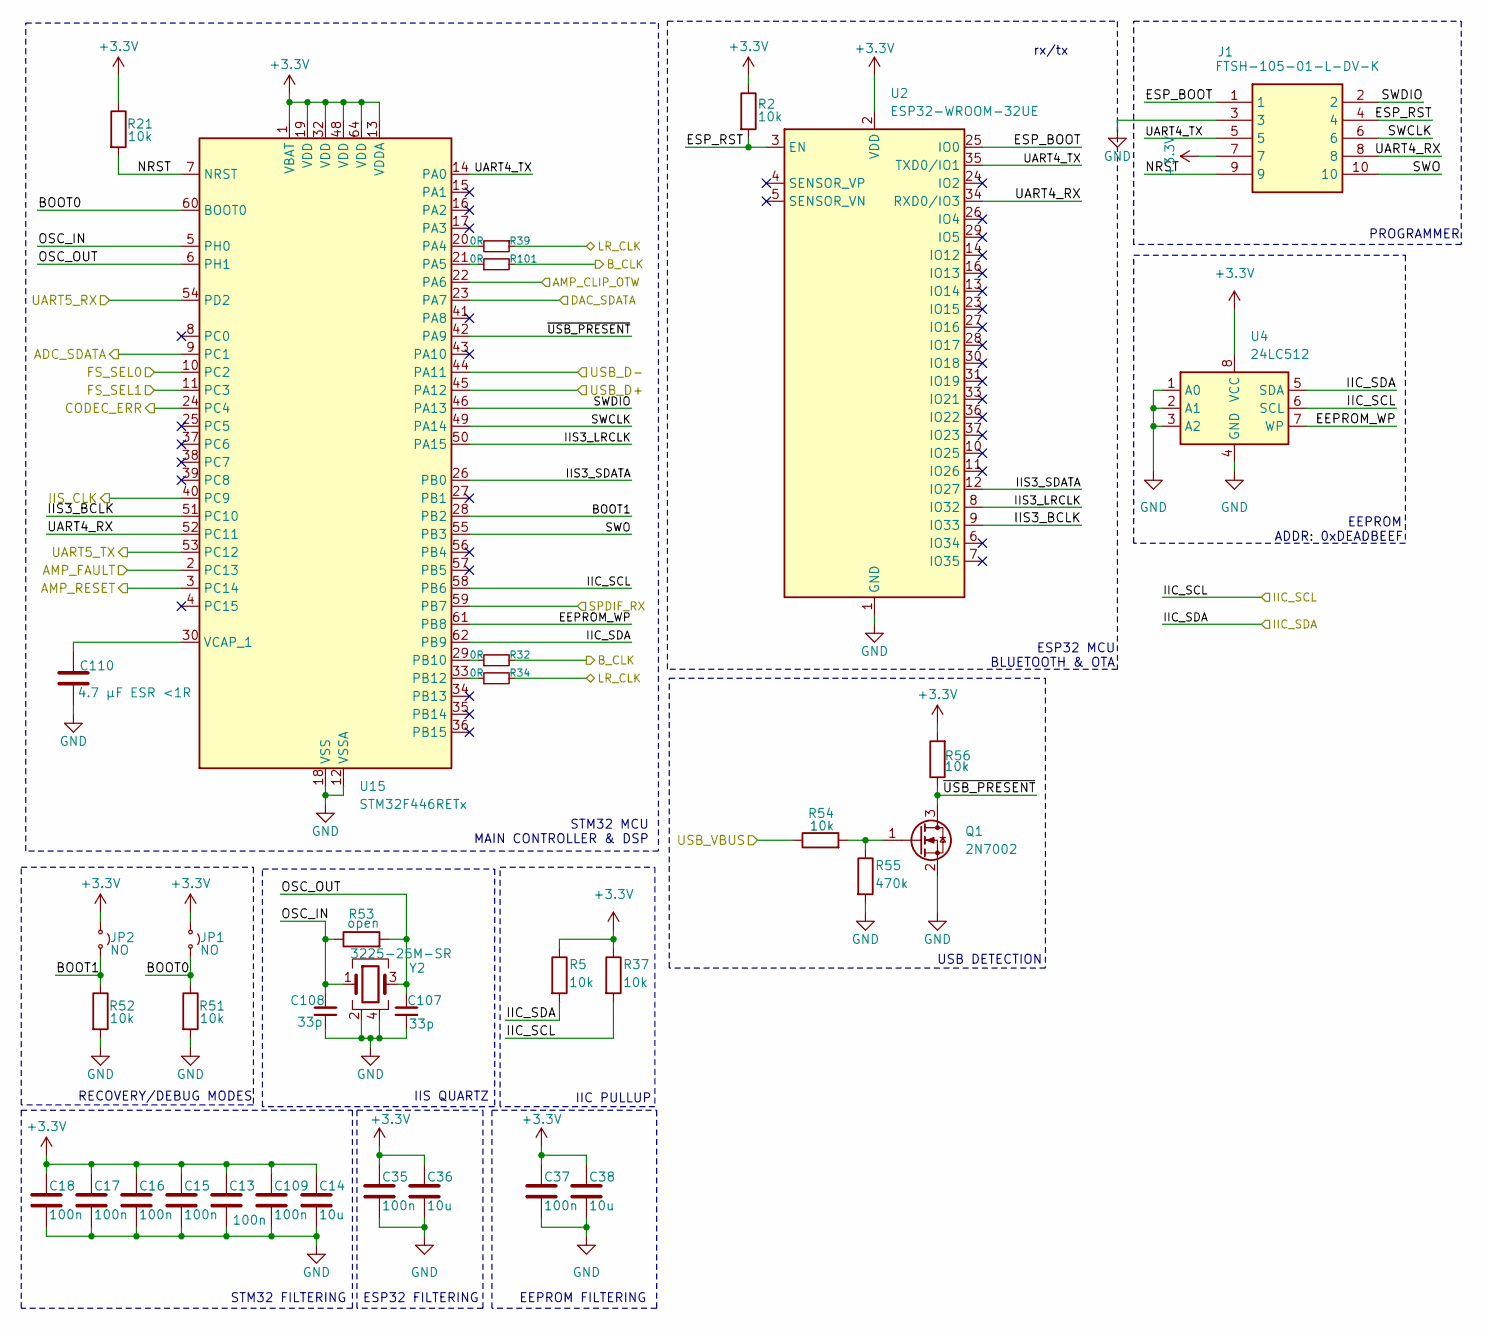
[picture p30: schematic mcu.kicad_sch]

Parts:
C13, C15, C16, C17, C18, C35, C37, C109: 100n; C_0603_1608Metric; Manufacturer_Part_Number 0603B104K500CT
C14, C36, C38: 10u; C_0603_1608Metric; Manufacturer_Part_Number GRM188R61E106KA73J
C107, C108: 33p; C_0603_1608Metric; Manufacturer_Part_Number CC0603JRNPO9BN330
C110: 4.7 μF ESR <1R; C_0603_1608Metric; Manufacturer_Part_Number CL10A475KP8NNNC
J1: FTSH-105-01-L-DV-K; FTSH10501LDVK; Manufacturer_Part_Number FTSH-105-01-L-DV-K
JP1, JP2: NO; PinHeader_2x01_P1.27mm_Vertical; Manufacturer_Part_Number DS1031-01-1*2P8BV3-1
Q1: 2N7002; SOT-23; Manufacturer_Part_Number 2N7002-G
R2, R5, R21, R37, R51, R52, R54, R56: 10k; R_0603_1608Metric; Manufacturer_Part_Number RC0603JR-0710KL
R32, R34, R39, R101: 0R; R_0603_1608Metric; Manufacturer_Part_Number RC0603JR-070RL
R53: open; R_0603_1608Metric
R55: 470k; R_0603_1608Metric; Manufacturer_Part_Number RC0603FR-07470KL
U2: ESP32-WROOM-32UE; Manufacturer_Part_Number ESP32-WROOM-32UE
U4: 24LC512; SOIC-8_3.9x4.9mm_P1.27mm; Manufacturer_Part_Number 24LC512-I/SN
U15: STM32F446RETx; LQFP-64_10x10mm_P0.5mm; Manufacturer_Part_Number STM32F446RETx
Y2: 3225-25M-SR; 322525MSR; Manufacturer_Part_Number 3225-25M-SR

Connections:
+3.3V: C13.1, C14.1, C15.1, C16.1, C17.1, C18.1, C35.1, C36.1, C37.1, C38.1, C109.1, J1.7, JP1.1 (A), JP2.1 (A), R2.1, R5.1, R21.1, R37.1, R56.2, U2.2 (VDD), U4.8 (VCC), U15.1 (VBAT), U15.13 (VDDA), U15.19 (VDD), U15.32 (VDD), U15.48 (VDD), U15.64 (VDD); also elsewhere on the board
/Amplifier/~CLIP_OTW: U15.22 (PA6); also elsewhere on the board
/Amplifier/~FAULT: U15.2 (PC13); also elsewhere on the board
/Amplifier/~RESET: U15.3 (PC14); also elsewhere on the board
/Codec & Frontend/CODEC_ERR: U15.24 (PC4); also elsewhere on the board
/Codec & Frontend/FS_SEL0: U15.10 (PC2); also elsewhere on the board
/Codec & Frontend/FS_SEL1: U15.11 (PC3); also elsewhere on the board
/MCU & BT/ADC_SDATA: U15.9 (PC1); also elsewhere on the board
/MCU & BT/BOOT0: JP1.2 (B), R51.1, U15.60 (BOOT0)
/MCU & BT/BOOT1: JP2.2 (B), R52.1, U15.28 (PB2)
/MCU & BT/B_CLK: R32.2, R101.2; also elsewhere on the board
/MCU & BT/DAC_SDATA: U15.23 (PA7); also elsewhere on the board
/MCU & BT/EEPROM_WP: U4.7 (WP), U15.61 (PB8)
/MCU & BT/ESP_BOOT: J1.1, U2.25 (IO0)
/MCU & BT/ESP_RST: J1.4, R2.2, U2.3 (EN)
/MCU & BT/IIC_SCL: R37.2, U4.6 (SCL), U15.58 (PB6); also elsewhere on the board
/MCU & BT/IIC_SDA: R5.2, U4.5 (SDA), U15.62 (PB9); also elsewhere on the board
/MCU & BT/IIS3_BCLK: U2.9 (IO33), U15.51 (PC10)
/MCU & BT/IIS3_LRCLK: U2.8 (IO32), U15.50 (PA15)
/MCU & BT/IIS3_SDATA: U2.12 (IO27), U15.26 (PB0)
/MCU & BT/IIS_CLK: U15.40 (PC9); also elsewhere on the board
/MCU & BT/LR_CLK: R34.2, R39.1; also elsewhere on the board
/MCU & BT/NRST: J1.9, R21.2, U15.7 (NRST)
/MCU & BT/OSC_IN: C108.2, R53.1, U15.5 (PH0), Y2.1
/MCU & BT/OSC_OUT: C107.2, R53.2, U15.6 (PH1), Y2.3
/MCU & BT/SPDIF_RX: U15.59 (PB7); also elsewhere on the board
/MCU & BT/SWCLK: J1.6, U15.49 (PA14)
/MCU & BT/SWDIO: J1.2, U15.46 (PA13)
/MCU & BT/SWO: J1.10, U15.55 (PB3)
/MCU & BT/UART4_RX: J1.8, U2.34 (RXD0/IO3), U15.52 (PC11)
/MCU & BT/UART4_TX: J1.5, U2.35 (TXD0/IO1), U15.14 (PA0)
/MCU & BT/UART5_RX: U15.54 (PD2); also elsewhere on the board
/MCU & BT/UART5_TX: U15.53 (PC12); also elsewhere on the board
/MCU & BT/~USB_PRESENT: Q1.3 (D), R56.1, U15.42 (PA9)
/USB_DM: U15.44 (PA11); also elsewhere on the board
/USB_DP: U15.45 (PA12); also elsewhere on the board
/USB_VBUS: R54.1; also elsewhere on the board
GND: C13.2, C14.2, C15.2, C16.2, C17.2, C18.2, C35.2, C36.2, C37.2, C38.2, C107.1, C108.1, C109.2, C110.2, J1.3, Q1.2 (S), R51.2, R52.2, R55.2, U2.1 (GND), U2.15 (GND), U2.38 (GND), U2.39 (GND), U4.1 (A0), U4.2 (A1), U4.3 (A2), U4.4 (GND), U15.12 (VSSA), U15.18 (VSS), U15.31 (VSS), U15.47 (VSS), U15.63 (VSS), Y2.2, Y2.4; also elsewhere on the board
unnamed: Q1.1 (G), R54.2, R55.1
unnamed: R39.2, U15.20 (PA4)
unnamed: R101.1, U15.21 (PA5)
unnamed: R32.1, U15.29 (PB10)
unnamed: R34.1, U15.33 (PB12)
unnamed: C110.1, U15.30 (VCAP_1)

Notes on the sheet:
EEPROM
ESP32 MCU
rx/tx
IIS QUARTZ
RECOVERY/DEBUG MODES
ADDR: 0xDEADBEEF
STM32 FILTERING
PROGRAMMER
BLUETOOTH & OTA
EEPROM FILTERING
IIC PULLUP
STM32 MCU MAIN CONTROLLER & DSP
USB DETECTION
ESP32 FILTERING

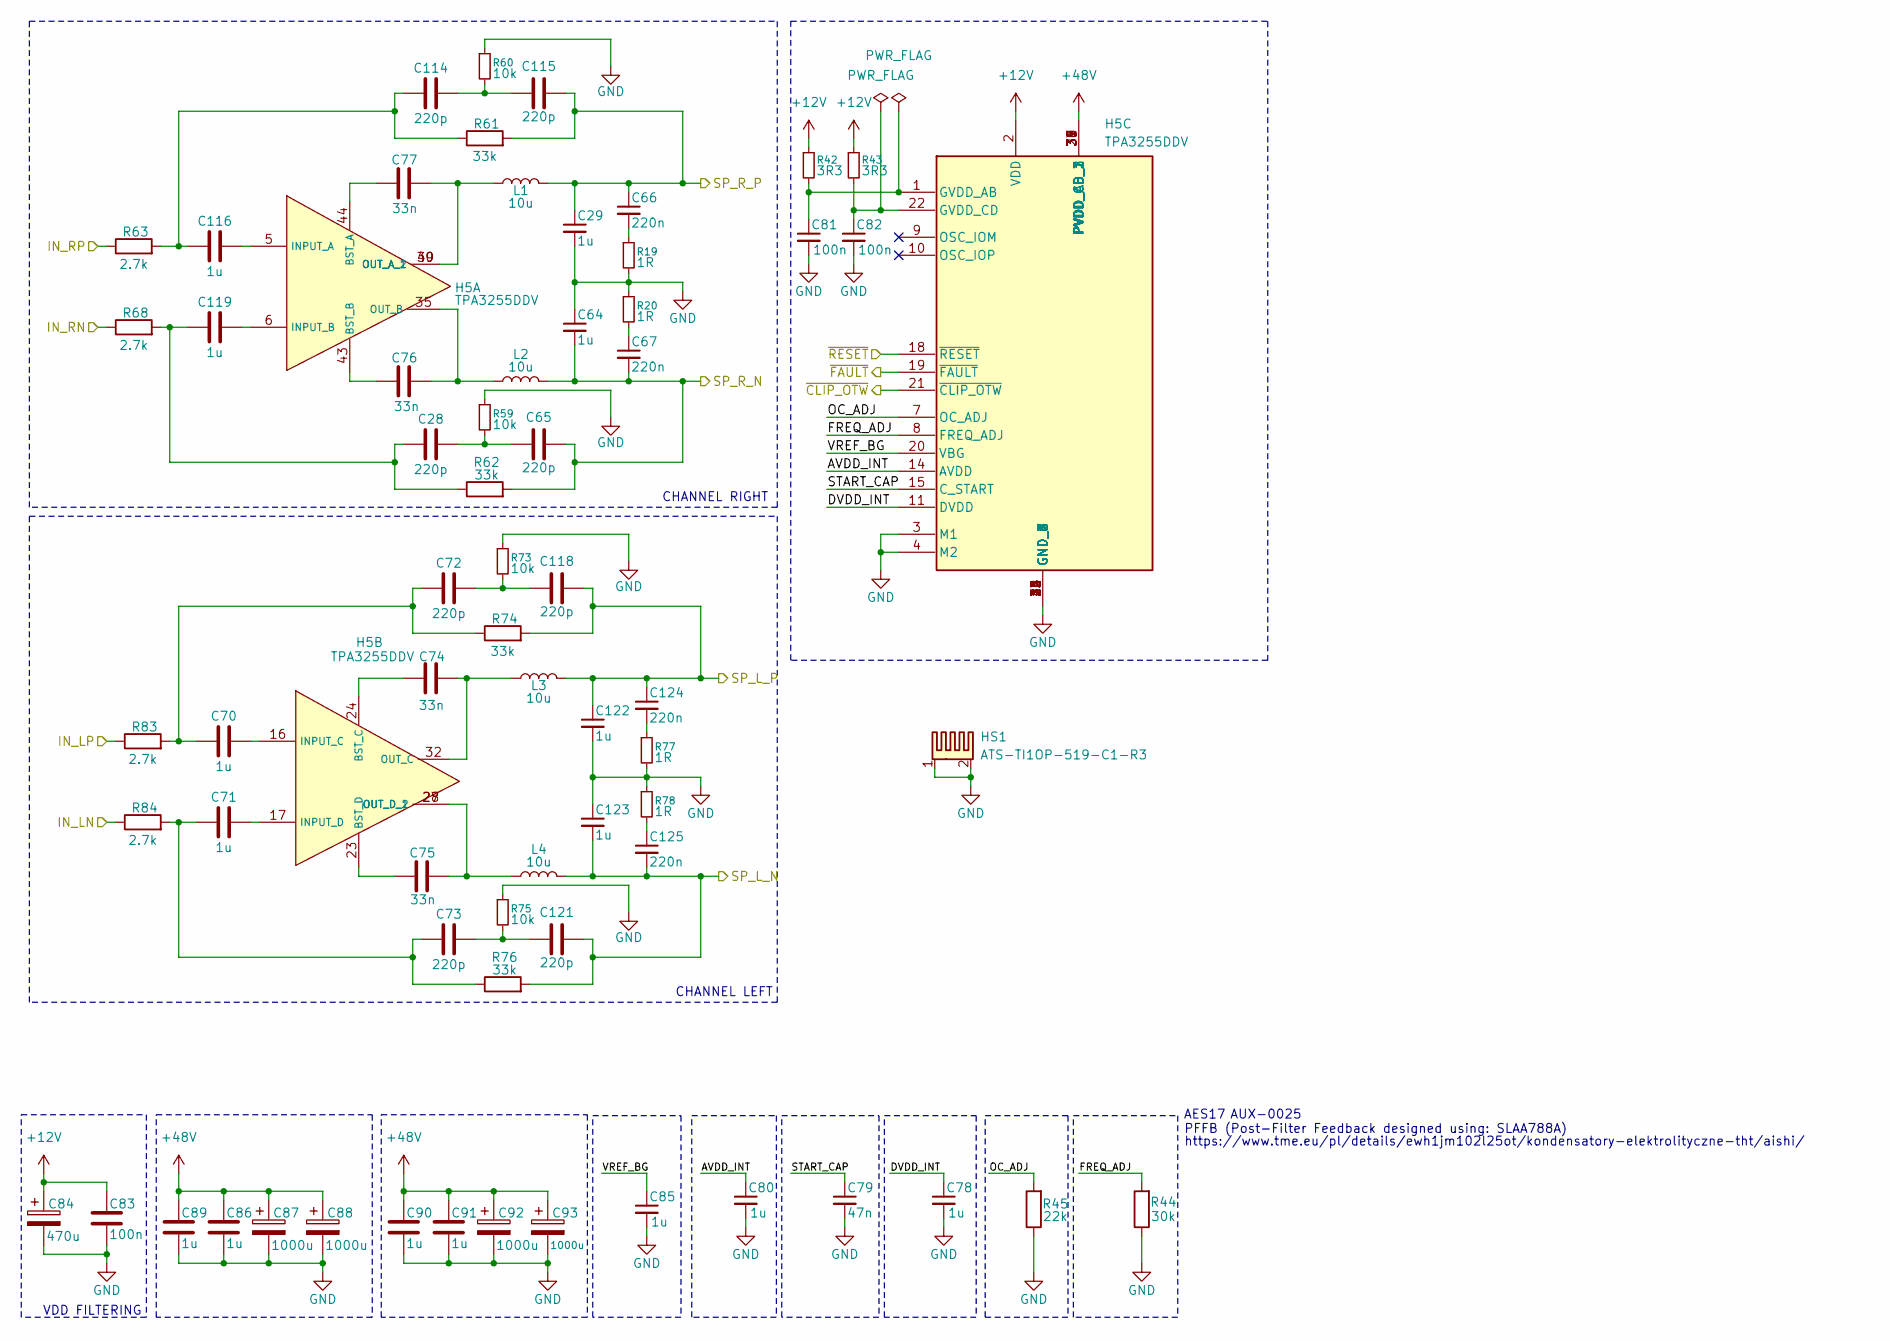
[picture p31: schematic amplifier.kicad_sch]

Parts:
C28, C65, C72, C73, C114, C115, C118, C121: 220p; C_1206_3216Metric; Manufacturer_Part_Number CC1206JRNPOBBN221
C29, C64, C122, C123: 1u; PHE-BV_KEM; Manufacturer_Part_Number PHE426HB7100JR06
C66, C67, C124, C125: 220n; C_1206_3216Metric; Manufacturer_Part_Number CL21B224KBFNNNG
C70, C71, C116, C119: 1u; C_0805_2012Metric; Manufacturer_Part_Number CL21B105KAFNNNE
C74, C75, C76, C77: 33n; C_1206_3216Metric; Manufacturer_Part_Number 1206B333K101CT
C78, C80, C85, C86, C89, C90, C91: 1u; C_0603_1608Metric; Manufacturer_Part_Number CL10A105KB8NNNC
C79: 47n; C_0603_1608Metric; Manufacturer_Part_Number CC0603KRX7R9BB473
C81, C82, C83: 100n; C_0603_1608Metric; Manufacturer_Part_Number 0603B104K500CT
C84: 470u; CP_EIA-6032-20_AVX-F; Manufacturer_Part_Number TAJC107K016RNJ
C87, C88, C92, C93: 1000u; CAPPRD750W80D1600H2500; Manufacturer_Part_Number EWH1JM102L25OT
H5: TPA3255DDV; SOP64P810X120-44N; Mouser Part Number 595-TPA3255DDV
HS1: ATS-TI1OP-519-C1-R3; Manufacturer_Part_Number ATS-TI1OP-519-C1-R3
L1, L2, L3, L4: 10u; MA5172AE; Manufacturer_Part_Number MA5172-AE
R19, R20, R77, R78: 1R; R_0805_2012Metric; Manufacturer_Part_Number RC0805FR-071RL
R42, R43: 3R3; R_0603_1608Metric; Manufacturer_Part_Number AC0603FR-073R3L
R44: 30k; R_0603_1608Metric; Manufacturer_Part_Number ERJPA3F3002V
R45: 22k; R_0603_1608Metric; Manufacturer_Part_Number WR06X2202FTL
R59, R60, R73, R75: 10k; R_0805_2012Metric; Manufacturer_Part_Number RC0805FR-0710KL
R61, R62, R74, R76: 33k; R_0805_2012Metric; Manufacturer_Part_Number RC0805FR-0733KL
R63, R68, R83, R84: 2.7k; R_0603_1608Metric; Manufacturer_Part_Number WR06X2701FTL

Connections:
+12V: C83.1, C84.1, H5.2 (VDD), R42.1, R43.1; also elsewhere on the board
+48V: C86.1, C87.1, C88.1, C89.1, C90.1, C91.1, C92.1, C93.1, H5.29 (PVDD_CD_1), H5.30 (PVDD_CD_2), H5.31 (PVDD_CD_3), H5.36 (PVDD_AB_1), H5.37 (PVDD_AB_2), H5.38 (PVDD_AB_3); also elsewhere on the board
/Amplifier/AVDD_INT: C80.1, H5.14 (AVDD)
/Amplifier/DVDD_INT: C78.1, H5.11 (DVDD)
/Amplifier/FREQ_ADJ: H5.8 (FREQ_ADJ), R44.2
/Amplifier/IN_LN: R84.1; also elsewhere on the board
/Amplifier/IN_LP: R83.1; also elsewhere on the board
/Amplifier/IN_RN: R68.1; also elsewhere on the board
/Amplifier/IN_RP: R63.1; also elsewhere on the board
/Amplifier/OC_ADJ: H5.7 (OC_ADJ), R45.2
/Amplifier/SP_L_N: C121.1, C123.2, C125.2, L4.2, R76.2; also elsewhere on the board
/Amplifier/SP_L_P: C118.1, C122.1, C124.1, L3.2, R74.2; also elsewhere on the board
/Amplifier/SP_R_N: C64.2, C65.1, C67.2, L2.2, R62.2; also elsewhere on the board
/Amplifier/SP_R_P: C29.1, C66.1, C115.1, L1.2, R61.2; also elsewhere on the board
/Amplifier/START_CAP: C79.1, H5.15 (C_START)
/Amplifier/VREF_BG: C85.1, H5.20 (VBG)
/Amplifier/~CLIP_OTW: H5.21 (~CLIP_OTW); also elsewhere on the board
/Amplifier/~FAULT: H5.19 (~FAULT); also elsewhere on the board
/Amplifier/~RESET: H5.18 (~RESET); also elsewhere on the board
GND: C29.2, C64.1, C78.2, C79.2, C80.2, C81.2, C82.2, C83.2, C84.2, C85.2, C86.2, C87.2, C88.2, C89.2, C90.2, C91.2, C92.2, C93.2, C122.2, C123.1, H5.3 (M1), H5.4 (M2), H5.12 (GND_1), H5.13 (GND_2), H5.25 (GND_3), H5.26 (GND_4), H5.33 (GND_5), H5.34 (GND_6), H5.41 (GND_7), H5.42 (GND_8), HS1.1, HS1.2, R19.2, R20.1, R44.1, R45.1, R59.1, R60.1, R73.1, R75.1, R77.2, R78.1; also elsewhere on the board
unnamed: C28.1, C65.2, R59.2
unnamed: C66.2, R19.1
unnamed: C67.1, R20.2
unnamed: C70.1, C72.2, R74.1, R83.2
unnamed: C71.1, C73.2, R76.1, R84.2
unnamed: C114.1, C115.2, R60.2
unnamed: C114.2, C116.1, R61.1, R63.2
unnamed: C72.1, C118.2, R73.2
unnamed: C28.2, C119.1, R62.1, R68.2
unnamed: C73.1, C121.2, R75.2
unnamed: C124.2, R77.1
unnamed: C125.1, R78.2
unnamed: C77.1, H5.44 (BST_A)
unnamed: C76.1, H5.43 (BST_B)
unnamed: C116.2, H5.5 (INPUT_A)
unnamed: C119.2, H5.6 (INPUT_B)
unnamed: C77.2, H5.39 (OUT_A_1), H5.40 (OUT_A_2), L1.1
unnamed: C76.2, H5.35 (OUT_B), L2.1
unnamed: C74.2, H5.24 (BST_C)
unnamed: C75.1, H5.23 (BST_D)
unnamed: C70.2, H5.16 (INPUT_C)
unnamed: C71.2, H5.17 (INPUT_D)
unnamed: C74.1, H5.32 (OUT_C), L3.1
unnamed: C75.2, H5.27 (OUT_D_1), H5.28 (OUT_D_2), L4.1
unnamed: C81.1, H5.1 (GVDD_AB), R42.2
unnamed: C82.1, H5.22 (GVDD_CD), R43.2

Notes on the sheet:
CHANNEL LEFT
CHANNEL RIGHT
VDD FILTERING
PFFB (Post-Filter Feedback designed using: SLAA788A)
AES17
https://www.tme.eu/pl/details/ewh1jm102l25ot/kondensatory-elektrolityczne-tht/aishi/
AUX-0025
