SSkrzypik03/DigitalAmplifier/hardware/mainboard/DigitalAmplifier.kicad_pcb

## KiCad design hardware/mainboard/DigitalAmplifier.kicad_pcb (continued)

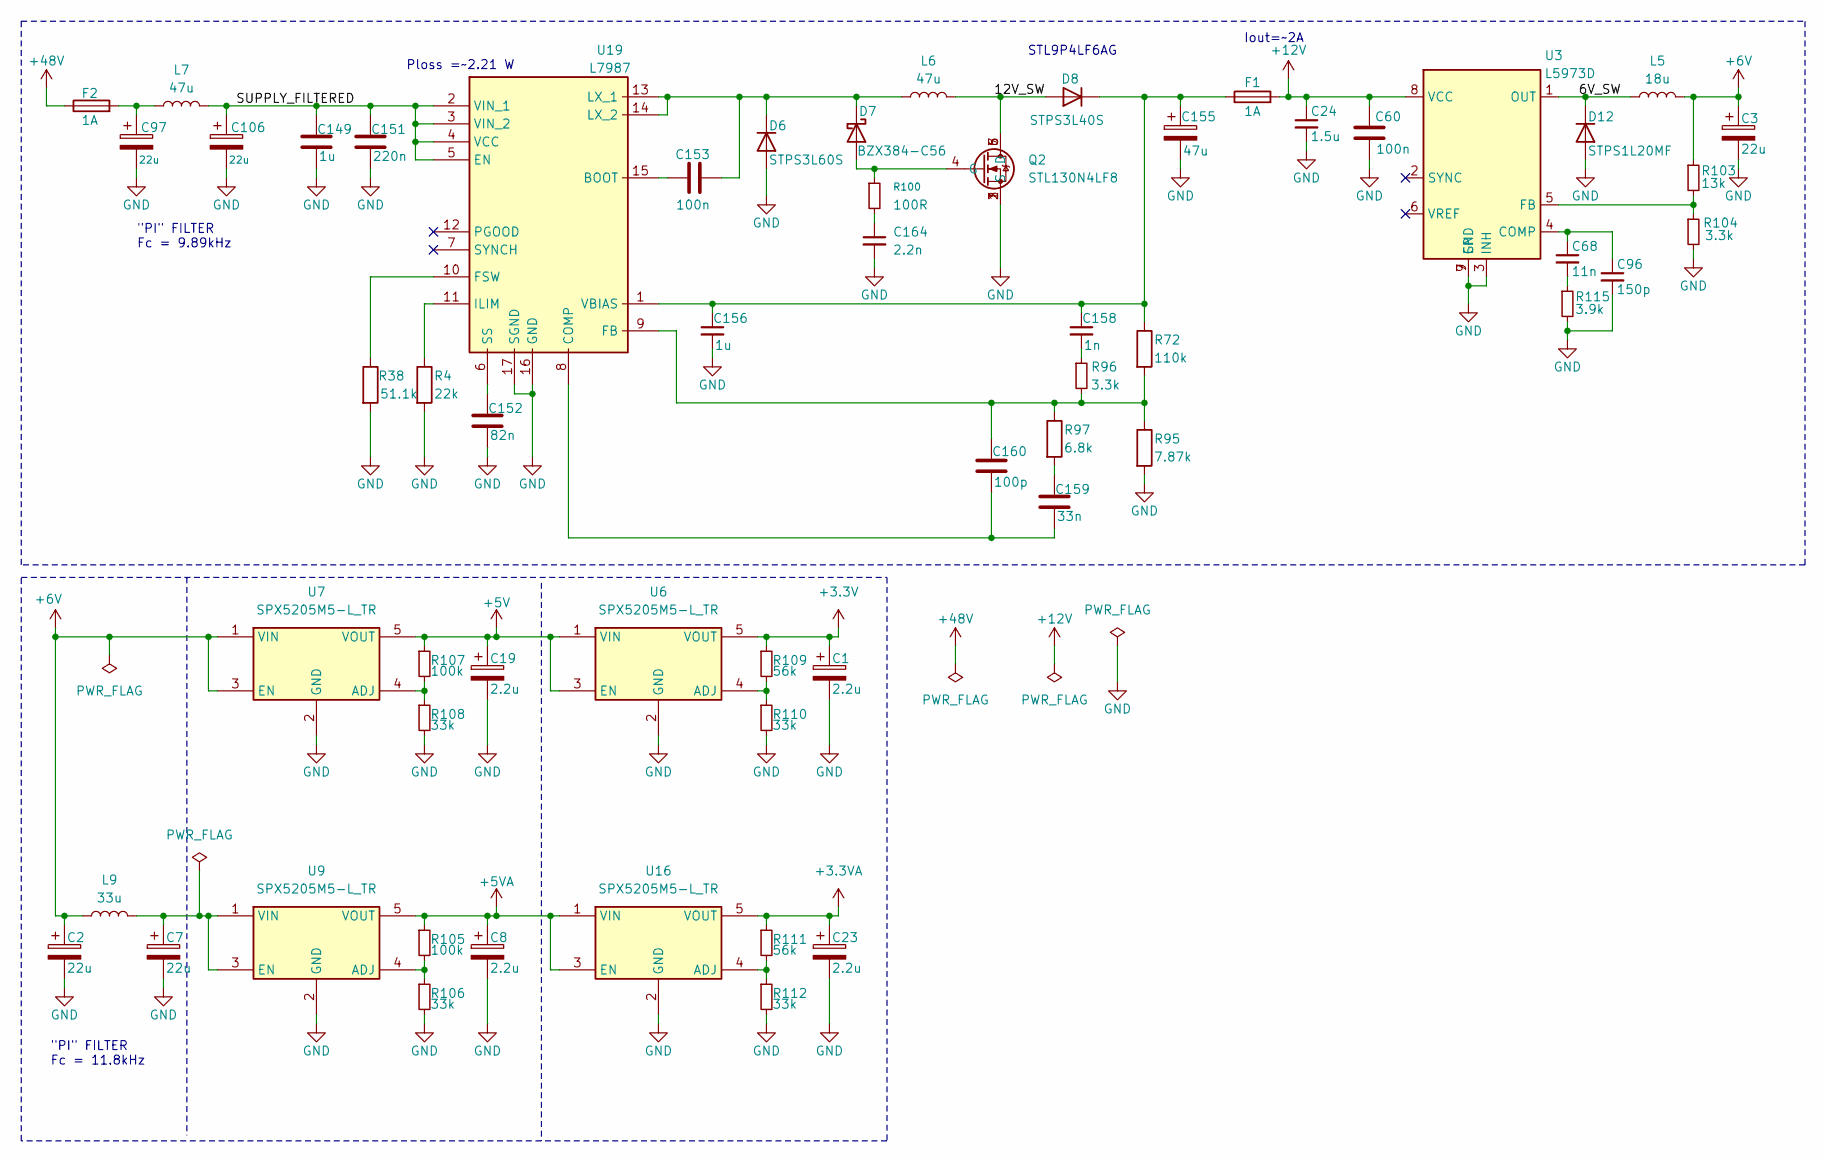
[picture p32: schematic supply.kicad_sch]

Parts:
C1, C8, C19, C23: 2.2u; CAPPM3216X180N; Manufacturer_Part_Number 293D225X9016A2TE3
C2, C3, C7: 22u; CAPPM3216X180N; Manufacturer_Part_Number 293D226X9010A2TE3
C24: 1.5u; C_0603_1608Metric; Manufacturer_Part_Number GRM155Z71A225KE01D
C60, C153: 100n; C_0603_1608Metric; Manufacturer_Part_Number 0603B104K500CT
C68: 11n; C_0603_1608Metric; Manufacturer_Part_Number GRM155Z71A225KE01D
C96: 150p; C_0603_1608Metric; Manufacturer_Part_Number GRM155Z71A225KE01D
C97, C106: 22u; CP_Radial_D4.0mm_P2.00mm; Manufacturer_Part_Number ECA1JHG220
C149, C156: 1u; C_0603_1608Metric; Manufacturer_Part_Number CL10A105KB8NNNC
C151: 220n; C_0603_1608Metric; Manufacturer_Part_Number CL10B224KO8NNNC
C152: 82n; C_0603_1608Metric; Manufacturer_Part_Number C0603C823K5RACTU
C155: 47u; CAPPM7343X310N; Manufacturer_Part_Number 293D476X9025D2TE3
C158: 1n; C_0603_1608Metric; Manufacturer_Part_Number 0603B102K500CT
C159: 33n; C_0603_1608Metric; Manufacturer_Part_Number CC0603JRX7R9BB333
C160: 100p; C_0603_1608Metric; Manufacturer_Part_Number CL10C101JB8NNNC
C164: 2.2n; C_0603_1608Metric; Manufacturer_Part_Number GRM1885C1H222JA01D
D6: STPS3L60S; D_SMC; Manufacturer_Part_Number STPS3L60S
D7: BZX384-C56; D_SOD-323; Manufacturer_Part_Number BZX384-C56
D8: STPS3L40S; D_SMC; Manufacturer_Part_Number STPS3L40S
D12: STPS1L20MF; Manufacturer_Part_Number STPS1L20MF
F1, F2: 1A; 0154001.DRT; Manufacturer_Part_Number 0154001.DRT
L5: 18u; L_Wurth_WE-PD2-1054; Manufacturer_Part_Number 744776118
L6: 47u; INDPM120120X1020N; Manufacturer_Part_Number MSS1210-473MED
L7: 47u; INDPM8180X540N; Manufacturer_Part_Number HCM1A0805V2-470-R
L9: 33u; WE-LQ_L49; Manufacturer_Part_Number 744045330
Q2: STL130N4LF8; STL9P4LF6AG; Manufacturer_Part_Number STL130N4LF8
R4: 22k; R_0603_1608Metric; Manufacturer_Part_Number WR06X2202FTL
R38: 51.1k; R_0603_1608Metric; Manufacturer_Part_Number ERJ3EKF5112V
R72: 110k; R_0603_1608Metric; Manufacturer_Part_Number ERJ3GEYJ114V
R95: 7.87k; R_0603_1608Metric; Manufacturer_Part_Number ERJ3EKF7871V
R96, R104: 3.3k; R_0603_1608Metric; Manufacturer_Part_Number ERA-2ARC2612X
R97: 6.8k; R_0603_1608Metric; Manufacturer_Part_Number RC0603FR-076K8L
R100: 100R; R_0603_1608Metric; Manufacturer_Part_Number WR06X1000FTL
R103: 13k; R_0603_1608Metric; Manufacturer_Part_Number RC0402BR-07220KL
R105, R107: 100k; R_0603_1608Metric; Manufacturer_Part_Number CRCW0402100KFKED
R106, R108, R110, R112: 33k; R_0603_1608Metric; Manufacturer_Part_Number ERA2AEB333X
R109, R111: 56k; R_0603_1608Metric; Manufacturer_Part_Number CR0402-FX-5602GLF
R115: 3.9k; R_0603_1608Metric; Manufacturer_Part_Number RC0402BR-07220KL
U3: L5973D; HSOP-8-1EP_3.9x4.9mm_P1.27mm_EP2.41x3.1mm_ThermalVias; Manufacturer_Part_Number L5973D013TR
U6, U7, U9, U16: SPX5205M5-L_TR; SOT95P280X145-5N; Mouser Part Number 701-SPX5205M5-L/TR
U19: L7987; SOP65P640X120-17N; Manufacturer_Part_Number L7987

Connections:
+3.3V: C1.1, R109.1, U6.5 (VOUT); also elsewhere on the board
+3.3VA: C23.1, R111.1, U16.5 (VOUT); also elsewhere on the board
+5V: C19.1, R107.1, U6.1 (VIN), U6.3 (EN), U7.5 (VOUT); also elsewhere on the board
+5VA: C8.1, R105.1, U9.5 (VOUT), U16.1 (VIN), U16.3 (EN); also elsewhere on the board
+6V: C2.1, C3.1, L5.2, L9.1, R103.1, U7.1 (VIN), U7.3 (EN)
+12V: C24.1, C60.2, F1.2, U3.8 (VCC); also elsewhere on the board
+48V: F2.1; also elsewhere on the board
/Supply/6V_SW: D12.2 (K), D12.3 (K), L5.1, U3.1 (OUT)
/Supply/12V_SW: D8.2 (A), L6.2, Q2.5 (D), Q2.6 (D), Q2.7 (D)
/Supply/SUPPLY_FILTERED: C106.1, C149.1, C151.1, L7.2, U19.2 (VIN_1), U19.3 (VIN_2), U19.4 (VCC), U19.5 (EN)
GND: C1.2, C2.2, C3.2, C7.2, C8.2, C19.2, C23.2, C24.2, C60.1, C96.2, C97.2, C106.2, C149.2, C151.2, C152.2, C155.2, C156.2, C164.2, D6.2 (A), D12.1 (A), Q2.1 (S), Q2.2 (S), Q2.3 (S), R4.2, R38.2, R95.2, R104.2, R106.2, R108.2, R110.2, R112.2, R115.2, U3.3 (INH), U3.7 (GND), U3.9 (EP), U6.2 (GND), U7.2 (GND), U9.2 (GND), U16.2 (GND), U19.16 (GND), U19.17 (SGND); also elsewhere on the board
unnamed: C68.2, R115.1
unnamed: C97.1, F2.2, L7.1
unnamed: C158.2, R96.1
unnamed: C159.1, R97.2
unnamed: C164.1, R100.2
unnamed: C153.2, D6.1 (K), D7.1 (K), L6.1, U19.13 (LX_1), U19.14 (LX_2)
unnamed: D7.2 (A), Q2.4 (G), R100.1
unnamed: C155.1, C156.1, C158.1, D8.1 (K), F1.1, R72.1, U19.1 (VBIAS)
unnamed: C68.1, C96.1, U3.4 (COMP)
unnamed: R103.2, R104.1, U3.5 (FB)
unnamed: R109.2, R110.1, U6.4 (ADJ)
unnamed: R107.2, R108.1, U7.4 (ADJ)
unnamed: R105.2, R106.1, U9.4 (ADJ)
unnamed: C7.1, L9.2, U9.1 (VIN), U9.3 (EN)
unnamed: R111.2, R112.1, U16.4 (ADJ)
unnamed: C153.1, U19.15 (BOOT)
unnamed: C159.2, C160.2, U19.8 (COMP)
unnamed: C160.1, R72.2, R95.1, R96.2, R97.1, U19.9 (FB)
unnamed: R38.1, U19.10 (FSW)
unnamed: R4.1, U19.11 (ILIM)
unnamed: C152.1, U19.6 (SS)

Notes on the sheet:
"PI" FILTER Fc = 11.8kHz
"PI" FILTER Fc = 9.89kHz
Iout=~2A
STL9P4LF6AG
Ploss =~2.21 W

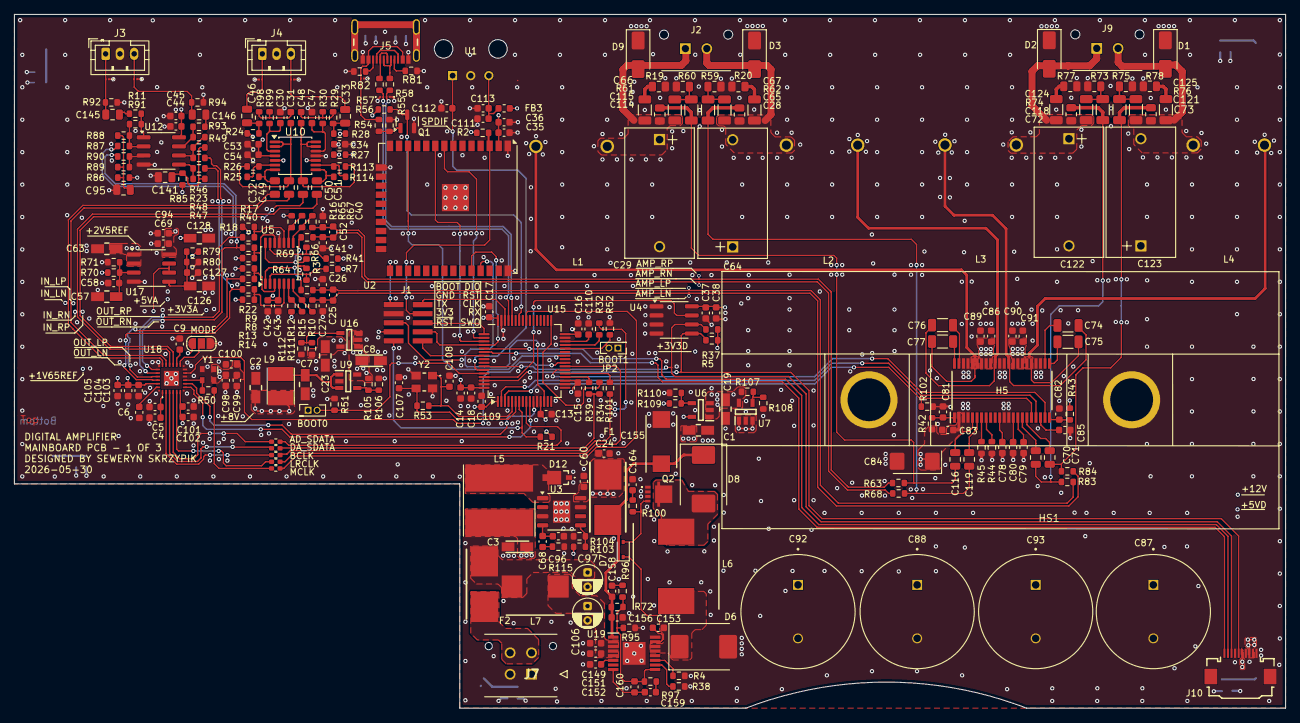
[picture p33: board DigitalAmplifier.kicad_pcb from above]

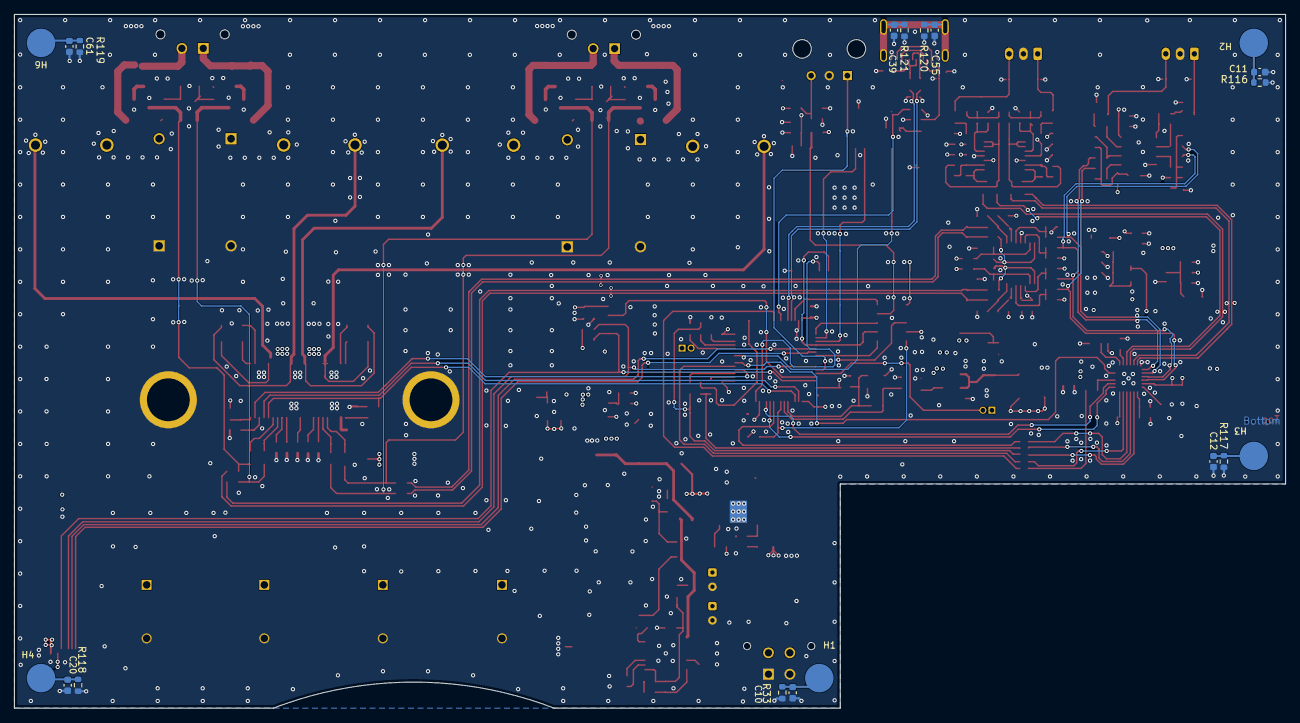
[picture p34: board DigitalAmplifier.kicad_pcb from below]

Board: 6 copper layers, 178.1 x 97.2 mm, 318 parts (19 on the bottom side), 187 nets.
