SSkrzypik03/DigitalAmplifier/hardware/supply/supply.kicad_pcb

## KiCad design hardware/supply/supply.kicad_pcb (2026-06-01)

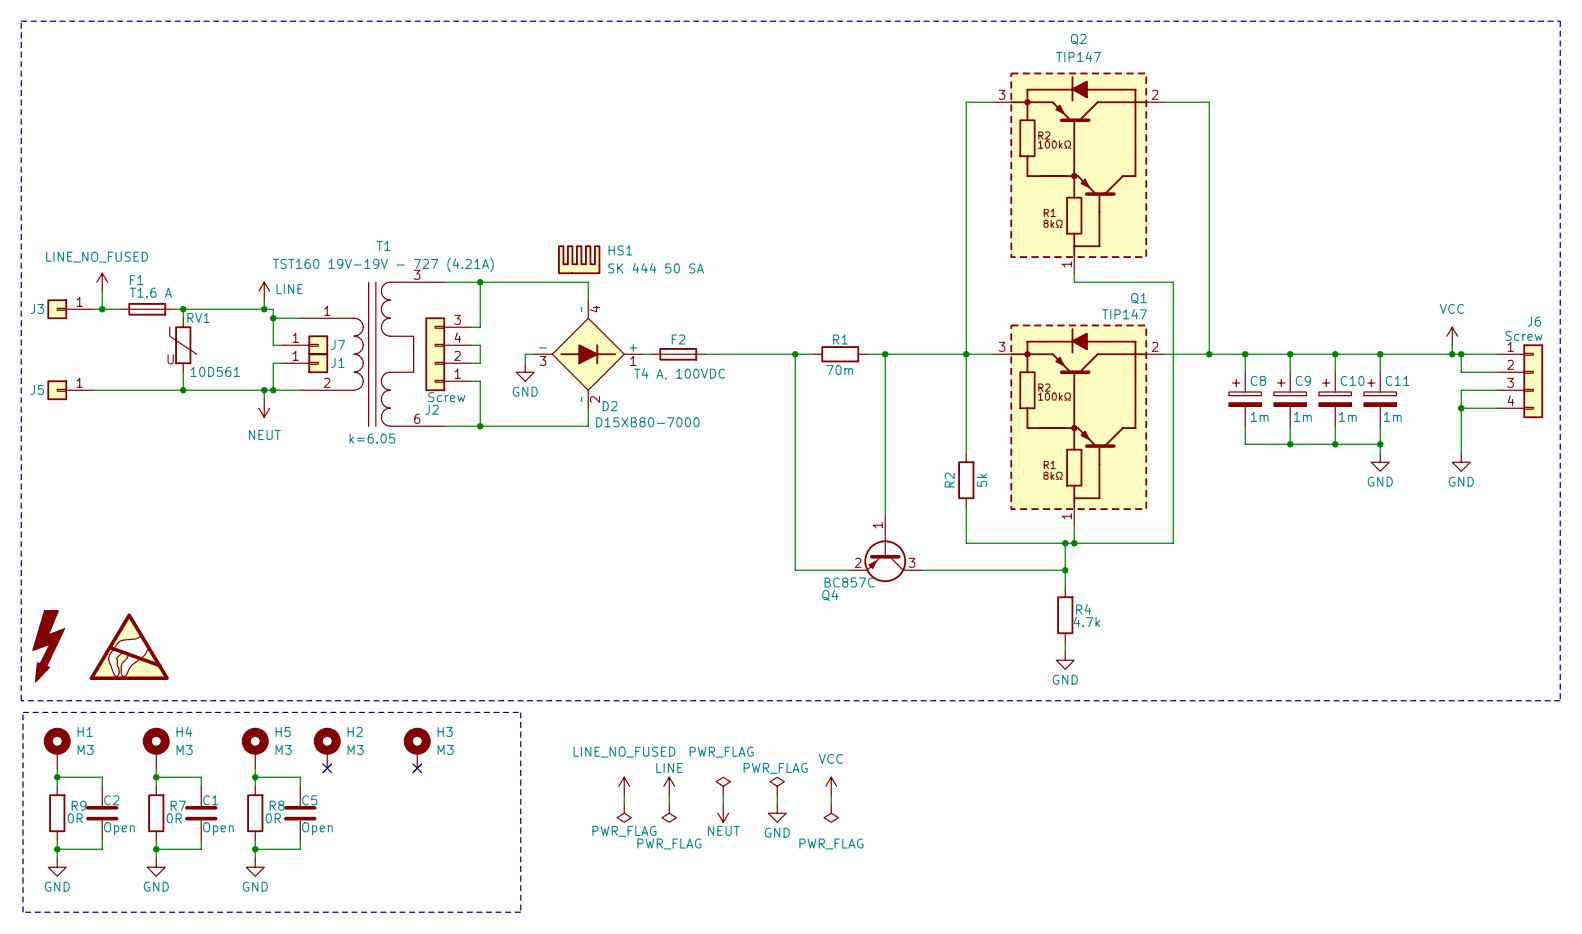
[picture p35: schematic supply.kicad_sch]

Parts:
C1, C2, C5: Open; C_0603_1608Metric
C8, C9, C10, C11: 1m; CP_Radial_D30.0mm_P10.00mm_SnapIn; Manufacturer_Part_Number HJ1J109M30050HC
D2: D15XB80-7000; D25XB1007000; Manufacturer_Part_Number D15XB80-7000
F1: T1.6 A; Fuseholder_Cylinder-5x20mm_Schurter_0031_8201_Horizontal_Op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; Manufacturer_Part_Number 0031.8201
F2: T4 A, 100VDC; FUSE_0154004.DRT; Manufacturer_Part_Number 0154004.DRT
H1, H2, H3, H4, H5: M3; WA-SMSI_97730256330; Manufacturer_Part_Number 9775056360R
HS1: SK 444 50 SA; Manufacturer_Part_Number SK_444 5_SA
J1, J3, J5, J7: Conn_01x01; 726386-2; Manufacturer_Part_Number 726386-2
J2, J6: Screw; 43045-04YY_121314; Manufacturer_Part_Number 43045-04YY_121314
Q1, Q2: TIP147; TO545P515X1560X2445-3P; Manufacturer_Part_Number TIP147
Q4: BC857C; SOT-23; Manufacturer_Part_Number BC857C
R1: 70m; Manufacturer_Part_Number TLRP3A30CR070FTE
R2: 5k; R_0805_2012Metric; Manufacturer_Part_Number RC0603FR-074K7L
R4: 4.7k; R_0805_2012Metric; Manufacturer_Part_Number RC0603FR-074K7L
R7, R8, R9: 0R; R_0603_1608Metric; Manufacturer_Part_Number CRCW06030000Z0EA
RV1: 10D561; MOV-14D_5.2MM-T_; Manufacturer_Part_Number 10D561
T1: TST160 19V-19V - 727 (4.21A)

Connections:
GND: C1.2, C2.2, C5.2, C8.2, C9.2, C10.2, C11.2, D2.3 (-), J6.3, J6.4, R4.1, R7.1, R8.1, R9.1
LINE: F1.2, J7.1 (Pin_1_1), RV1.1, T1.1 (AA)
LINE_NO_FUSED: F1.1, J3.1 (Pin_1_1)
NEUT: J1.1 (Pin_1_1), J5.1 (Pin_1_1), RV1.2, T1.2 (AB)
unnamed: C1.1, H4.1 (1_1), R7.2
unnamed: C2.1, H1.1 (1_1), R9.2
unnamed: C5.1, H5.1 (1_1), R8.2
unnamed: D2.1 (+), F2.1
unnamed: D2.2 (~~), J2.1, T1.6 (SD)
unnamed: J2.2, J2.4
unnamed: D2.4 (~~), J2.3, T1.3 (SA)
unnamed: Q1.1 (B), Q2.1 (B), Q4.3 (C), R2.1, R4.2
unnamed: Q1.3 (E), Q2.3 (E), Q4.1 (B), R1.2, R2.2
unnamed: F2.2, Q4.2 (E), R1.1
VCC: C8.1, C9.1, C10.1, C11.1, J6.1, J6.2, Q1.2 (C), Q2.2 (C)

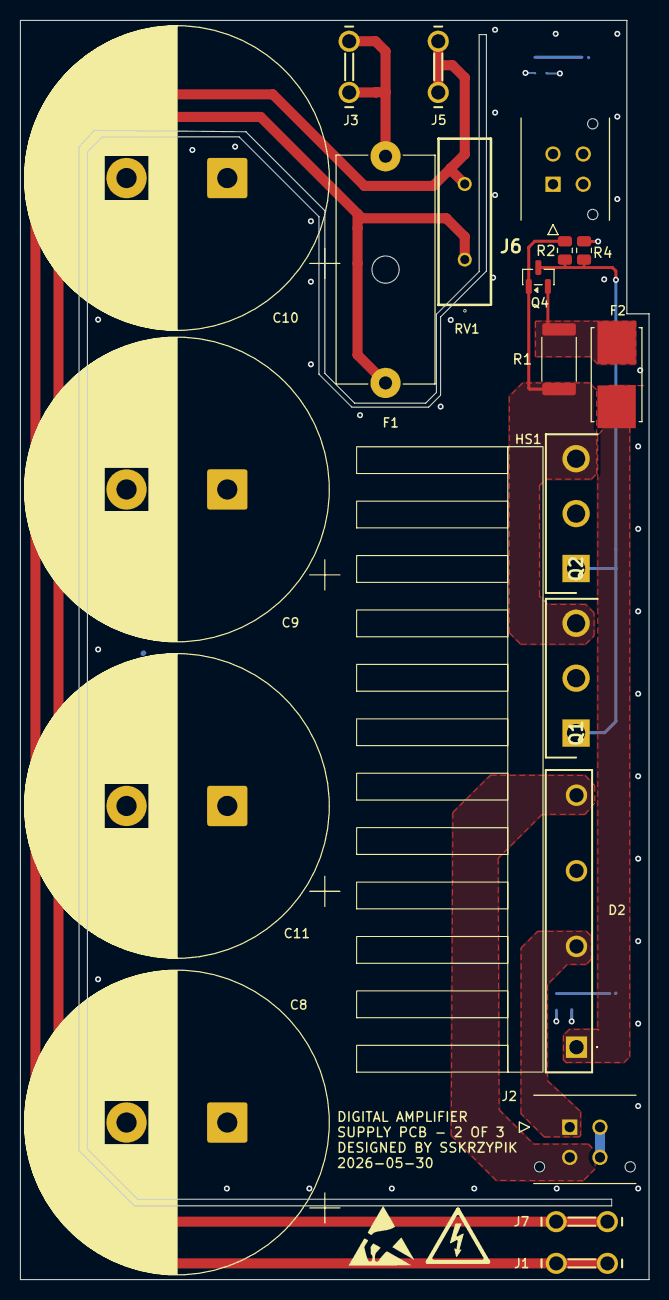
[picture p36: board supply.kicad_pcb from above]

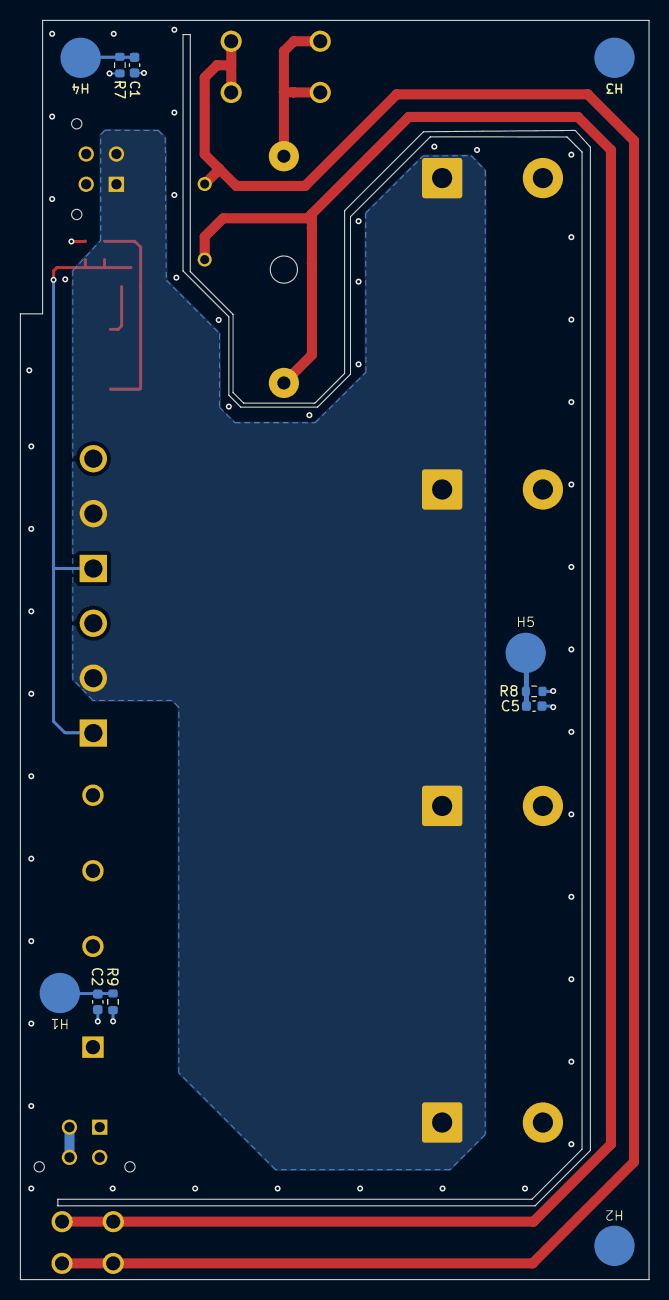
[picture p37: board supply.kicad_pcb from below]

Board: 4 copper layers, 62.4 x 125.0 mm, 32 parts (11 on the bottom side), 15 nets.
