SSkrzypik03/DigitalAmplifier/hardware/front_panel/FrontPanel.kicad_pcb

## KiCad design hardware/front_panel/FrontPanel.kicad_pcb (2026-05-26)

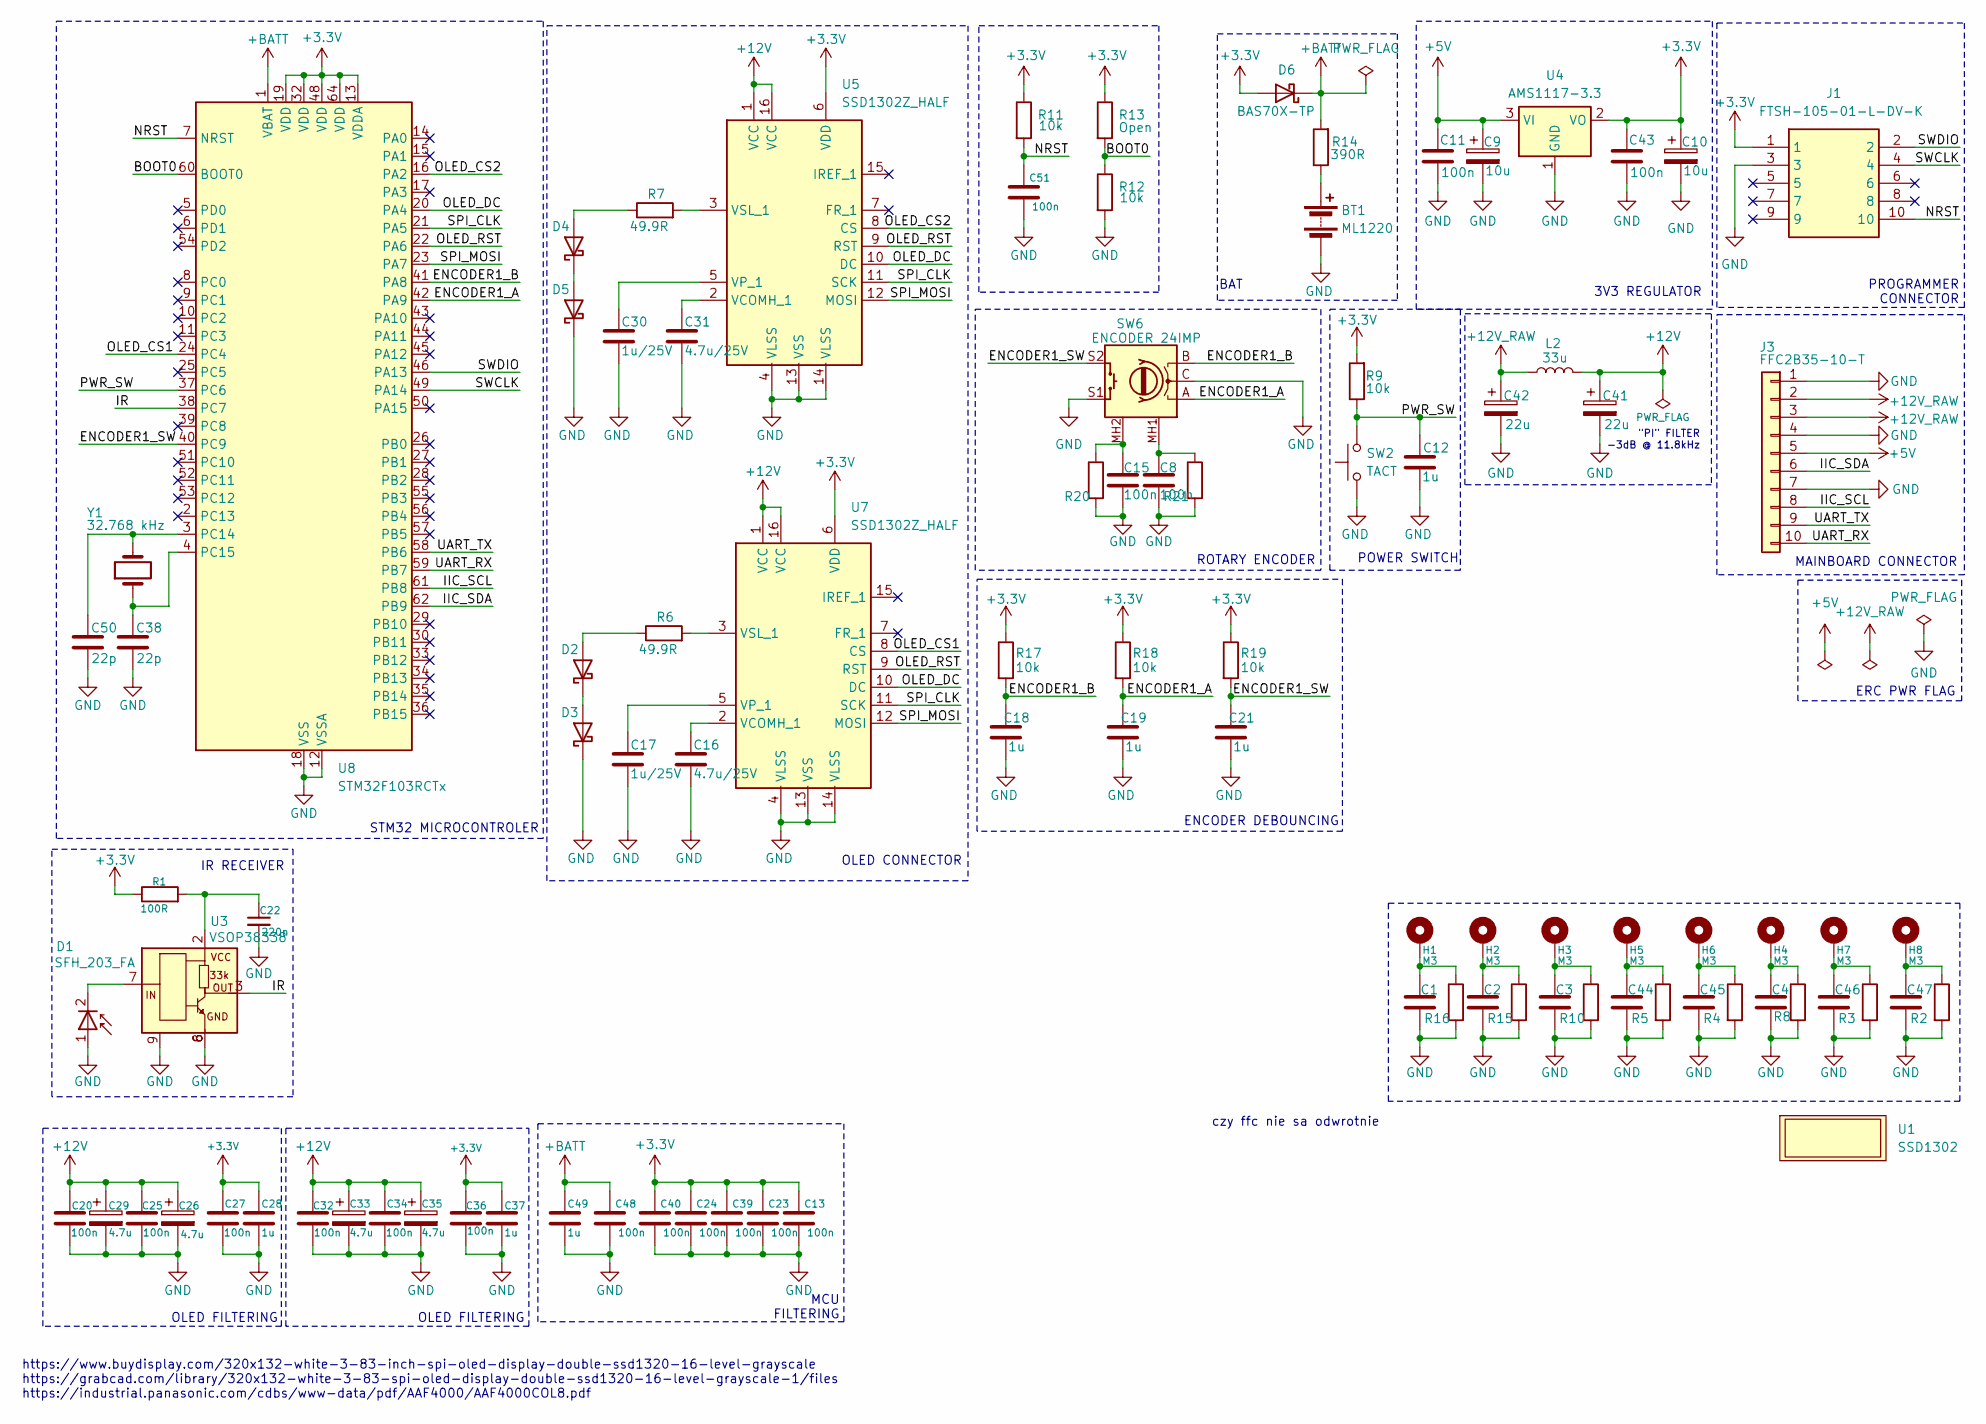
[picture p38: schematic FrontPanel.kicad_sch]

Parts:
BT1: ML1220; BatteryHolder_LINX_BAT-HLD-012-SMT
C1, C2, C3, C4, C8, C11, C13, C15, C20, C23, C24, C25, C27, C32, C34, C36, C39, C40, C43, C44, C45, C46, C47, C48, C51: 100n; C_0603_1608Metric
C9, C10: 10u; CAPPM3216X180N
C12, C18, C19, C21, C28, C37, C49: 1u; C_0603_1608Metric
C16, C31: 4.7u/25V; C_0603_1608Metric
C17, C30: 1u/25V; C_0603_1608Metric
C22: 220n; C_0603_1608Metric
C26, C29, C33, C35: 4.7u; CAPPM3528X210N; Manufacturer_Part_Number 293D475X9016B2TE3
C38, C50: 22p; C_0603_1608Metric
C41, C42: 22u; CAPPM3216X180N; Manufacturer_Part_Number 293D226X9010A2TE3
D1: SFH_203_FA; SFH203FA; Manufacturer_Part_Number SFH 203 FA
D2, D3, D4, D5: RB500VM-40TE-17; D_SOD-323F; Manufacturer_Part_Number RB500VM-40TE-17
D6: BAS70X-TP; D_SOD-523; Manufacturer_Part_Number BAS70X-TP
H1, H2, H3, H4, H5, H6, H7, H8: M3; MountingHole_3.2mm_M3_Pad_Via
J1: FTSH-105-01-L-DV-K; FTSH10501LDVK; Manufacturer_Part_Number FTSH-105-01-L-DV-K
J3: FFC2B35-10-T; FFC2B3510T
L2: 33u; WE-LQ_L49; Manufacturer_Part_Number WE-LQ_L49
R1: 100R; R_0603_1608Metric
R2, R3, R4, R5, R8, R10, R15, R16, R20, R21: 1M; R_0603_1608Metric
R6, R7: 49.9R; R_0603_1608Metric
R9, R11, R12, R17, R18, R19: 10k; R_0603_1608Metric
R13: Open; R_0603_1608Metric
R14: 390R; R_0603_1608Metric
SW2: TACT; SW_SPST_PTS645Sx43SMTR92
SW6: ENCODER 24IMP; PEC11R4220FS0024; Manufacturer_Part_Number PEC11R-4220F-S0024
U1: SSD1302
U3: VSOP38338; SON50P200X200X81-9N-D; Mouser Part Number 782-VSOP38338
U4: AMS1117-3.3; SOT-223-3_TabPin2
U5, U7: SSD1302Z_HALF; 527461671; Manufacturer_Part_Number 52746-1671
U8: STM32F103RCTx; LQFP-64_10x10mm_P0.5mm
Y1: 32.768 kHz; QT3CD32768KDZYT; Manufacturer_Part_Number QT3CD-32.768KDZY-T

Connections:
+3.3V: C10.1, C13.1, C23.1, C24.1, C27.1, C28.1, C36.1, C37.1, C39.1, C40.1, C43.1, D6.2 (A), J1.1, R1.1, R9.2, R11.1, R13.1, R17.1, R18.1, R19.1, U4.2 (VO), U5.6 (VDD), U7.6 (VDD), U8.13 (VDDA), U8.19 (VDD), U8.32 (VDD), U8.48 (VDD), U8.64 (VDD)
+5V: C9.1, C11.1, J3.5, U4.3 (VI)
+12V: C20.1, C25.1, C26.1, C29.1, C32.1, C33.1, C34.1, C35.1, C41.1, L2.2, U5.1 (VCC), U5.16 (VCC), U7.1 (VCC), U7.16 (VCC)
+12V_RAW: C42.1, J3.2, J3.3, L2.1
+BATT: C48.1, C49.1, D6.1 (K), R14.2, U8.1 (VBAT)
/BOOT0: R12.1, R13.2, U8.60 (BOOT0)
/ENCODER1_A: C19.1, R18.2, SW6.A, U8.42 (PA9)
/ENCODER1_B: C18.1, R17.2, SW6.B, U8.41 (PA8)
/ENCODER1_SW: C21.1, R19.2, SW6.S2, U8.40 (PC9)
/IIC_SCL: J3.8, U8.61 (PB8)
/IIC_SDA: J3.6, U8.62 (PB9)
/IR: U3.3 (OUT), U8.38 (PC7)
/NRST: C51.1, J1.10, R11.2, U8.7 (NRST)
/OLED_CS1: U7.8 (CS), U8.24 (PC4)
/OLED_CS2: U5.8 (CS), U8.16 (PA2)
/OLED_DC: U5.10 (DC), U7.10 (DC), U8.20 (PA4)
/OLED_RST: U5.9 (RST), U7.9 (RST), U8.22 (PA6)
/PWR_SW: C12.1, R9.1, SW2.2, U8.37 (PC6)
/SPI_CLK: U5.11 (SCK), U7.11 (SCK), U8.21 (PA5)
/SPI_MOSI: U5.12 (MOSI), U7.12 (MOSI), U8.23 (PA7)
/SWCLK: J1.4, U8.49 (PA14)
/SWDIO: J1.2, U8.46 (PA13)
/UART_RX: J3.10, U8.59 (PB7)
/UART_TX: J3.9, U8.58 (PB6)
GND: BT1.2 (-), C1.2, C2.2, C3.2, C4.2, C8.2, C9.2, C10.2, C11.2, C12.2, C13.2, C15.2, C16.2, C17.2, C18.2, C19.2, C20.2, C21.2, C22.2, C23.2, C24.2, C25.2, C26.2, C27.2, C28.2, C29.2, C30.2, C31.2, C32.2, C33.2, C34.2, C35.2, C36.2, C37.2, C38.2, C39.2, C40.2, C41.2, C42.2, C43.2, C44.2, C45.2, C46.2, C47.2, C48.2, C49.2, C50.2, C51.2, D1.1 (A), D3.1 (K), D5.1 (K), J1.3, J3.1, J3.4, J3.7, R2.2, R3.2, R4.2, R5.2, R8.2, R10.2, R12.2, R15.2, R16.2, R20.2, R21.2, SW2.1, SW6.C, SW6.S1, U3.6 (GND), U3.8 (GND), U3.9 (EP), U4.1 (GND), U5.4 (VLSS), U5.13 (VSS), U5.14 (VLSS), U7.4 (VLSS), U7.13 (VSS), U7.14 (VLSS), U8.12 (VSSA), U8.18 (VSS), U8.31 (VSS), U8.47 (VSS), U8.63 (VSS)
unnamed: BT1.1 (+), R14.1
unnamed: C1.1, H1.1 (1_1), R16.1
unnamed: C2.1, H2.1 (1_1), R15.1
unnamed: C3.1, H3.1 (1_1), R10.1
unnamed: C4.1, H4.1 (1_1), R8.1
unnamed: C8.1, R21.1, SW6.MH1
unnamed: C15.1, R20.1, SW6.MH2
unnamed: C44.1, H5.1 (1_1), R5.1
unnamed: C45.1, H6.1 (1_1), R4.1
unnamed: C46.1, H7.1 (1_1), R3.1
unnamed: C47.1, H8.1 (1_1), R2.1
unnamed: D1.2 (K), U3.7 (IN)
unnamed: D2.2 (A), R6.1
unnamed: D2.1 (K), D3.2 (A)
unnamed: D4.2 (A), R7.1
unnamed: D4.1 (K), D5.2 (A)
unnamed: C22.1, R1.2, U3.2 (VCC)
unnamed: C31.1, U5.2 (VCOMH_1)
unnamed: C30.1, U5.5 (VP_1)
unnamed: R7.2, U5.3 (VSL_1)
unnamed: C16.1, U7.2 (VCOMH_1)
unnamed: C17.1, U7.5 (VP_1)
unnamed: R6.2, U7.3 (VSL_1)
unnamed: C50.1, U8.3 (PC14), Y1.2
unnamed: C38.1, U8.4 (PC15), Y1.1

Notes on the sheet:
https://www.buydisplay.com/320x132-white-3-83-inch-spi-oled-display-double-ssd1320-16-level-grayscale https://grabcad.com/library/320x132-white-3-83-spi-oled-display-double-ssd1320-16-level-grayscale-1/files https://industrial.panasonic.com/cdbs/www-data/pdf/AAF4000/AAF4000COL8.pdf
ROTARY ENCODER
czy ffc nie sa odwrotnie
OLED CONNECTOR
MAINBOARD CONNECTOR
IR RECEIVER
ENCODER DEBOUNCING
"PI" FILTER -3dB @ 11.8kHz
POWER SWITCH
STM32 MICROCONTROLER
OLED FILTERING
PROGRAMMER CONNECTOR
MCU FILTERING
ERC PWR FLAG
BAT
3V3 REGULATOR

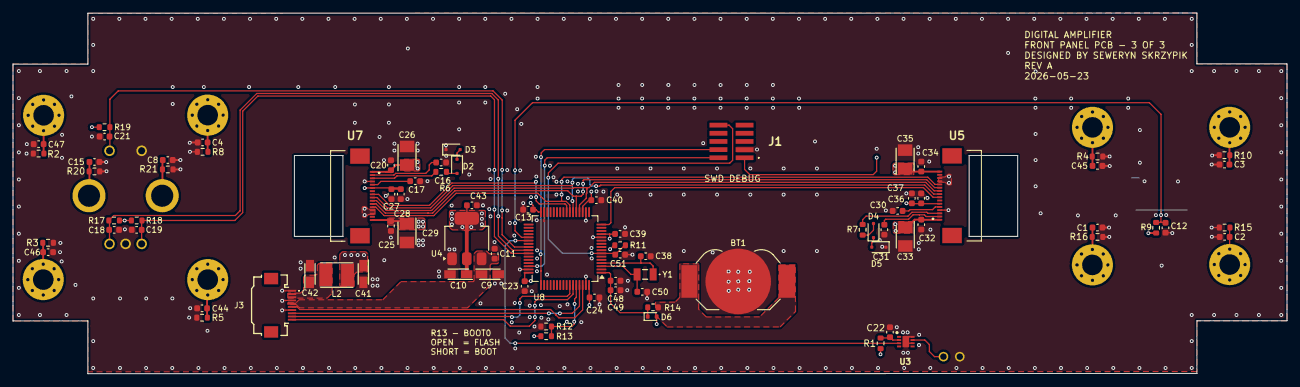
[picture p39: board FrontPanel.kicad_pcb from above]

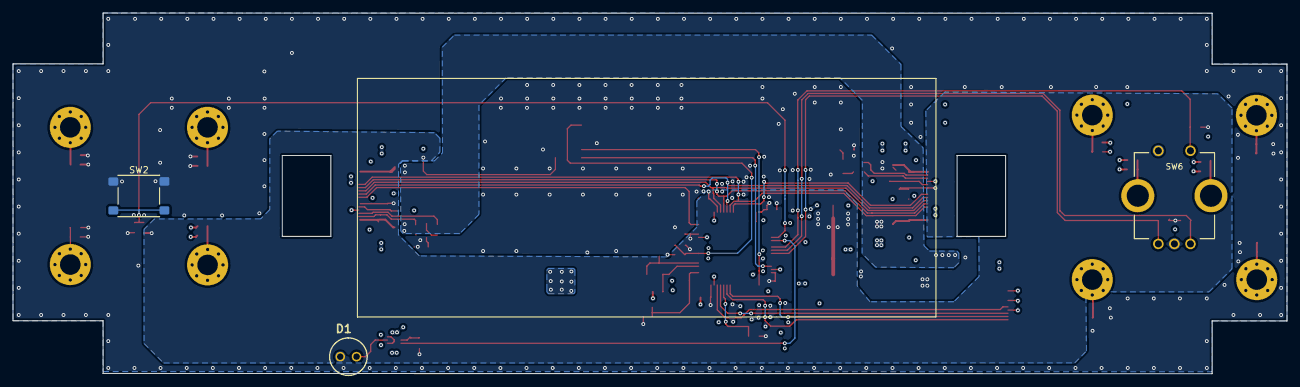
[picture p40: board FrontPanel.kicad_pcb from below]

Board: 4 copper layers, 198.4 x 56.2 mm, 94 parts (3 on the bottom side), 50 nets.
