SSkrzypik03/DigitalAmplifier/(commit log)

2026-05-24 Add power supply and front panel PCBs
    [DigitalAmplifier-B_Cu [SIG].gbr, DigitalAmplifier-B_Mask.gbr, DigitalAmplifier-B_Silkscreen.gbr, DigitalAmplifier-Edge_Cuts.gbr, DigitalAmplifier-F_Cu [SIG].gbr, DigitalAmplifier-F_Mask.gbr, DigitalAmplifier-F_Silkscreen.gbr, DigitalAmplifier-In1_Cu [RRP].gbr]
2026-05-24 Add power supply simulation files
2026-05-24 docs: add project and PCB images
2026-05-26 replace mosfets with bjts in inrush current limiter
    [supply.kicad_pcb, supply.kicad_sch]
2026-05-26 swap power connectors and flip front panel PCB orientation
    [FrontPanel.kicad_pcb, supply.kicad_pcb, supply.kicad_sch]
2026-06-01 Prepare PCB for production
    [DigitalAmplifier.csv, DigitalAmplifier.kicad_pcb, DigitalAmplifier.kicad_sch, FrontPanel.csv, FrontPanel.kicad_sch, amplifier.kicad_sch, codec.kicad_sch, front_26_05_26.step]
2026-06-03 docs update
    [DigitalAmplifier.csv, FrontPanel.csv, Supply.csv]
2026-06-03 Add enclosure CAD models
    [0100.2130_02.step, 1053072-1.step, Allen key bolt M8.step, Antena 3 dBi 5.8 GHz v3.step, Binding Post Gold-Plated Screwable.step, ER-OLED0383-1.step, RCA_chassis_Red.step, RCA_chassis_White.step]
